MikolajPawel/PneumaticServoDrive_Arduino_byPM/README.md

## *If you wish to download all files from this repository you need to click "Code" and then "Download ZIP"*
# Didcatic workstation for pneumatic servo-drive with Arduino UNO and fast-switching valves.
https://youtu.be/sTllF3iPF24

https://youtu.be/fmIs1yKPOr8

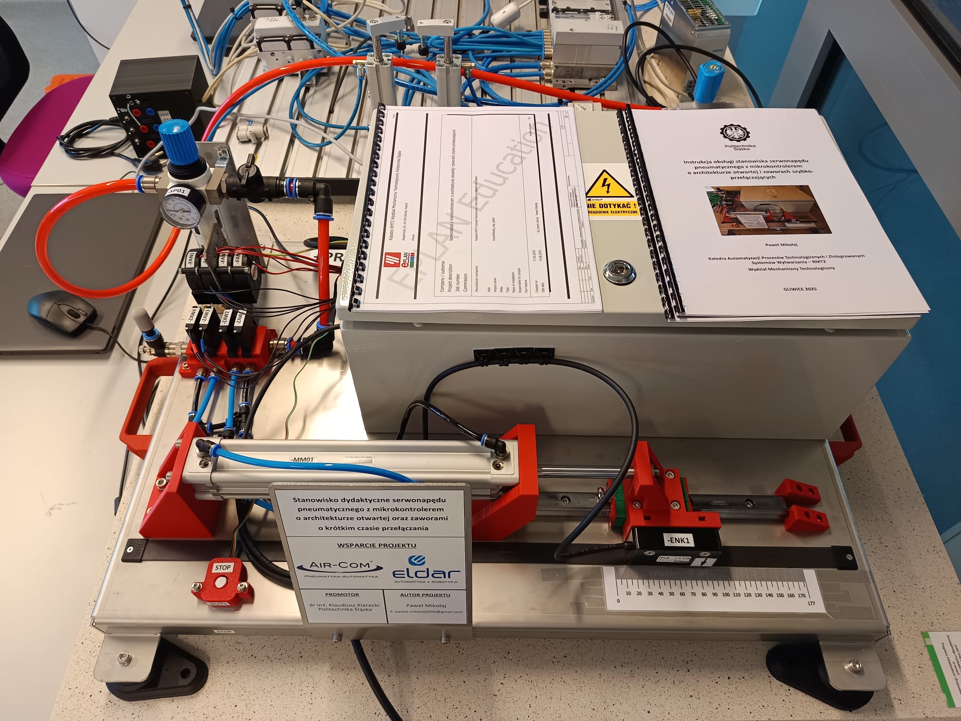
[picture p1: Zdjecie_stanowiska.jpg]
