MikolajPawel/PneumaticServoDrive_Arduino_byPM/Kod_Arduino/Biblioteki/PIDv1.h_link.txt

https://github.com/br3ttb/Arduino-PID-Library
