MikolajPawel/PneumaticServoDrive_Arduino_byPM/Konstrukcja/STL/PrzyciskSTOP_1.stl

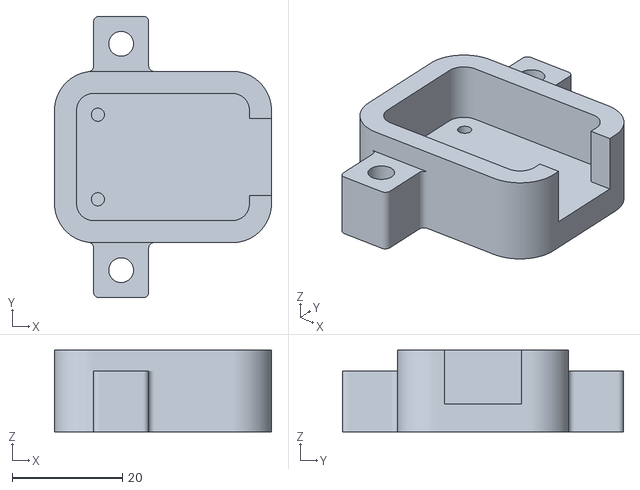
[picture p116: CAD file, 2025-08-22]
Konstrukcja/STL/PrzyciskSTOP_1.stl
39.4 x 51.1 x 14.8
