MikolajPawel/PneumaticServoDrive_Arduino_byPM/Konstrukcja/STL/uchwyt_konwerter_V1.stl

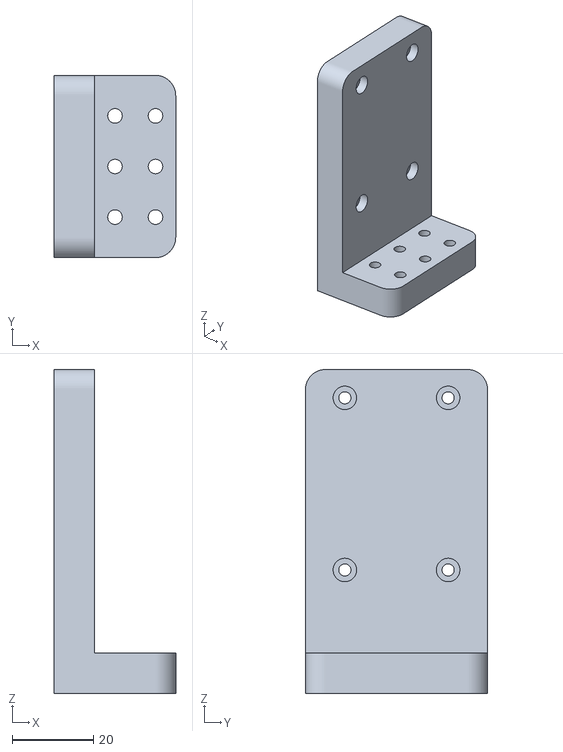
[picture p117: CAD file, 2025-08-22]
Konstrukcja/STL/uchwyt_konwerter_V1.stl
30.0 x 45.0 x 80.0
