MikolajPawel/PneumaticServoDrive_Arduino_byPM/Konstrukcja/STL/uchwyt_silownika2_V1.stl

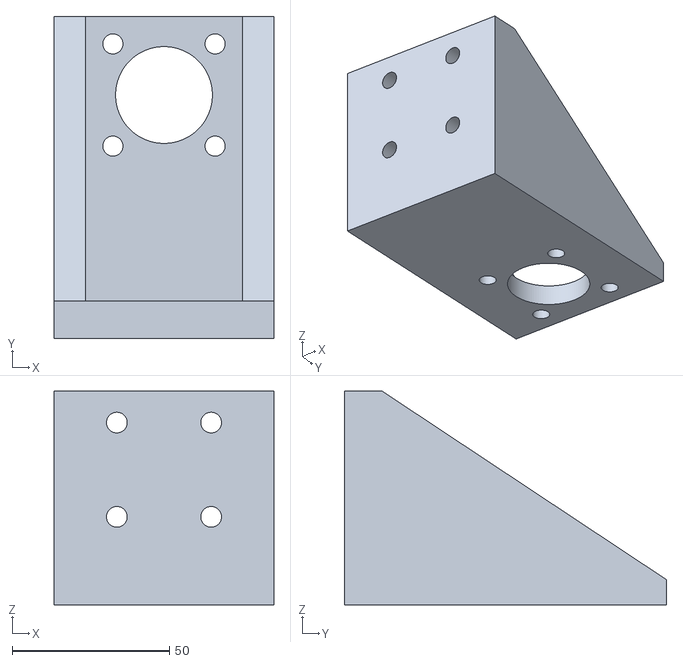
[picture p118: CAD file, 2025-08-22]
Konstrukcja/STL/uchwyt_silownika2_V1.stl
70.0 x 102.5 x 68.0
