MikolajPawel/PneumaticServoDrive_Arduino_byPM/Konstrukcja/STL/PrzyciskSTOP_2.stl

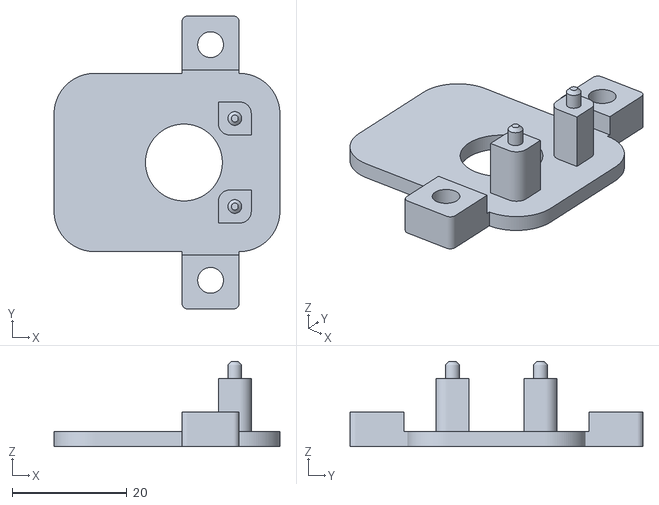
[picture p119: CAD file, 2025-08-22]
Konstrukcja/STL/PrzyciskSTOP_2.stl
39.4 x 51.1 x 14.9
