MikolajPawel/PneumaticServoDrive_Arduino_byPM/Konstrukcja/STL/uchwyt_silownika1_V1.stl

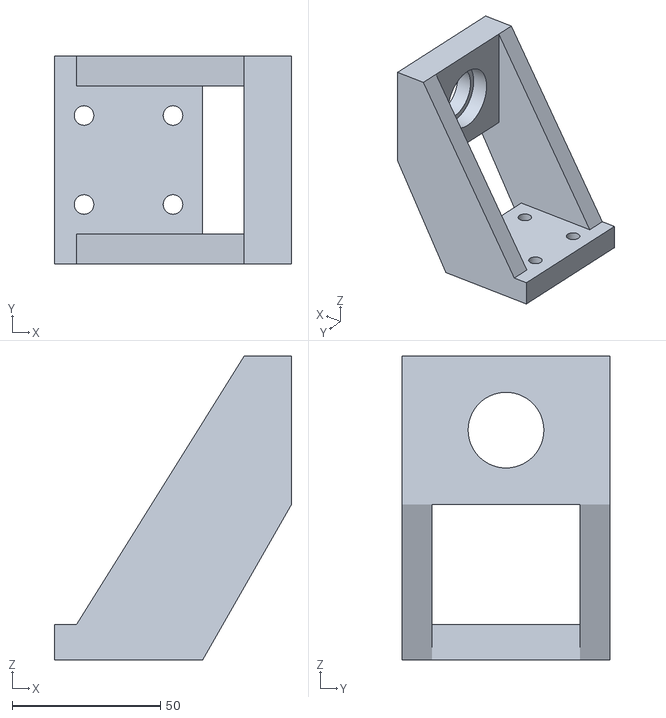
[picture p120: CAD file, 2025-08-22]
Konstrukcja/STL/uchwyt_silownika1_V1.stl
80.0 x 70.0 x 102.5
