MikolajPawel/PneumaticServoDrive_Arduino_byPM/Konstrukcja/STL/arduino_tuleja2_V2.stl

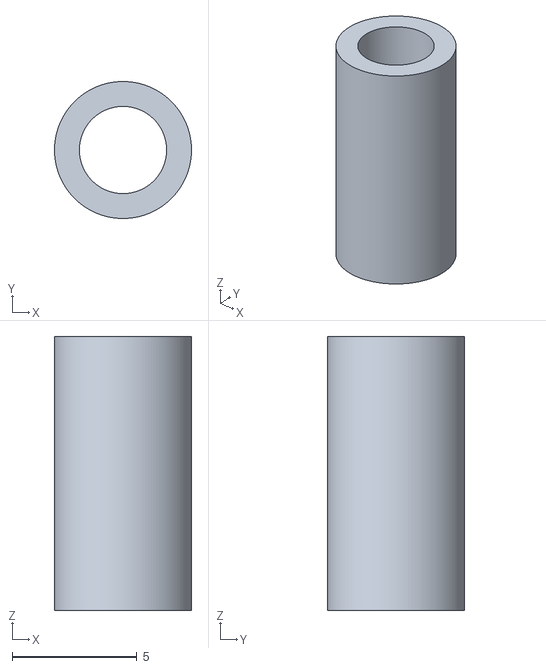
[picture p121: CAD file, 2025-08-22]
Konstrukcja/STL/arduino_tuleja2_V2.stl
5.50 x 5.50 x 11.0
