MikolajPawel/PneumaticServoDrive_Arduino_byPM/Konstrukcja/STL/blokada_hiwin_V1.stl

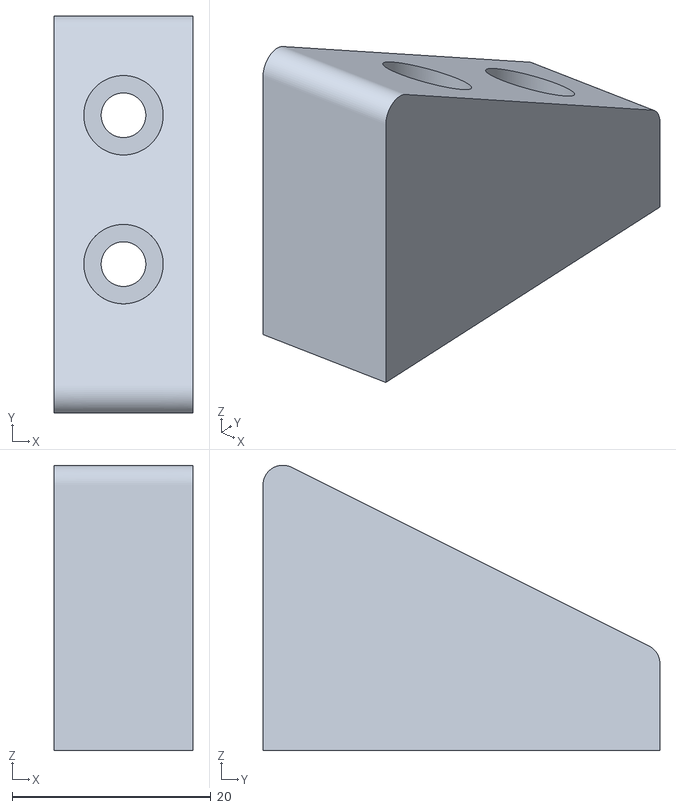
[picture p122: CAD file, 2025-08-22]
Konstrukcja/STL/blokada_hiwin_V1.stl
14.0 x 40.0 x 28.8
