MikolajPawel/PneumaticServoDrive_Arduino_byPM/Konstrukcja/STL/wozek_enkodera_V1.stl

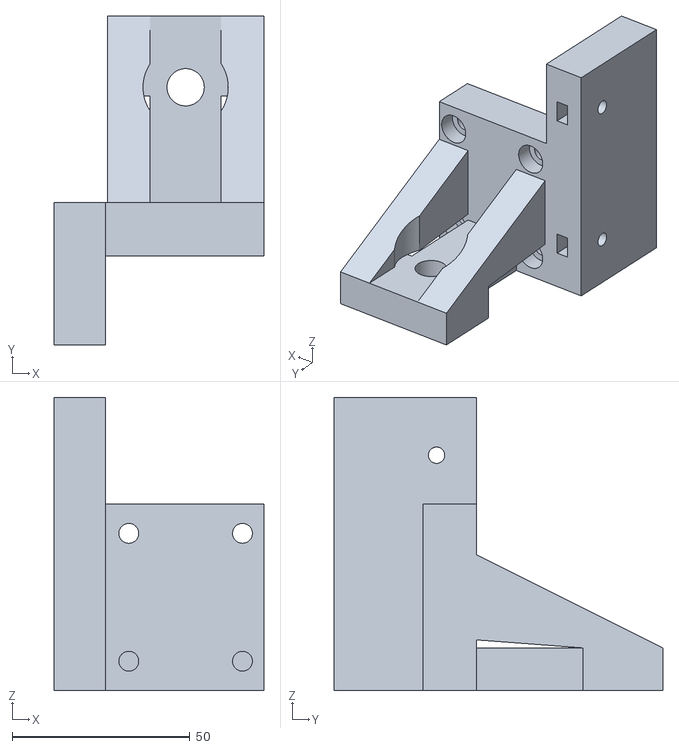
[picture p123: CAD file, 2025-08-22]
Konstrukcja/STL/wozek_enkodera_V1.stl
59.0 x 92.5 x 82.5
