MikolajPawel/PneumaticServoDrive_Arduino_byPM/Konstrukcja/STL/uchwyt_arduino_V1.stl

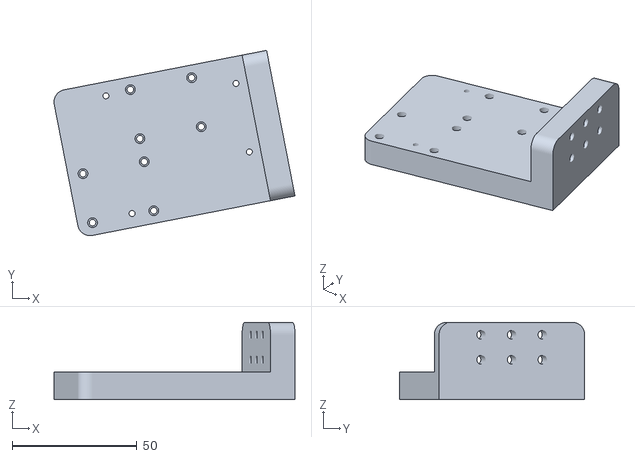
[picture p124: CAD file, 2025-08-22]
Konstrukcja/STL/uchwyt_arduino_V1.stl
96.5 x 74.2 x 31.0
