MikolajPawel/PneumaticServoDrive_Arduino_byPM/(list of files, cad)

Other CAD files:
Konstrukcja/inventor/Templates/English/ANSI (in).dwg
Konstrukcja/inventor/Templates/Metric/JIS.dwg
Konstrukcja/inventor/Templates/Standard.dwg
Konstrukcja/inventor/Templates/Metric/DIN.dwg
Konstrukcja/inventor/Templates/Metric/GOST.dwg
Konstrukcja/inventor/Templates/Metric/GB.dwg
Konstrukcja/inventor/Templates/Metric/MULTIPIT - 20220318 Template z tabelką.dwg
Konstrukcja/inventor/Templates/Metric/BSI.dwg
Konstrukcja/inventor/Templates/Metric/ANSI (mm).dwg
Konstrukcja/inventor/Templates/Metric/ISO.dwg
Konstrukcja/inventor/Design Data/AIT/Mold Design/mold design stop pin.ipt
Konstrukcja/inventor/Design Data/Cable & Harness/en-US/harness.iam
Konstrukcja/inventor/Design Data/Tube & Pipe/en-US/piping runs.iam
Konstrukcja/inventor/Templates/English/ANSI (in).idw
Konstrukcja/inventor/Templates/English/Mold Design (in).iam
Konstrukcja/inventor/Templates/English/Sheet Metal (in).ipt
Konstrukcja/inventor/Templates/English/Standard (in).iam
Konstrukcja/inventor/Templates/English/Standard (in).ipn
Konstrukcja/inventor/Templates/English/Standard (in).ipt
Konstrukcja/inventor/Templates/English/Weldment (ANSI).iam
Konstrukcja/inventor/Templates/Factory/Factory Layout (in).iam
Konstrukcja/inventor/Templates/Factory/Factory Layout (mm).iam
Konstrukcja/inventor/Templates/Metric/ANSI (mm).idw
Konstrukcja/inventor/Templates/Metric/BSI.idw
Konstrukcja/inventor/Templates/Metric/Balustrady - test/Fence generator - assembly level one.iam
Konstrukcja/inventor/Templates/Metric/Balustrady - test/Fence generator - assembly level one/Frame/Frame 1723491092086.iam
Konstrukcja/inventor/Templates/Metric/Balustrady - test/Fence generator - assembly level one/Frame/ISO 10799-2 42.4x2.0 1723491095419.ipt
Konstrukcja/inventor/Templates/Metric/Balustrady - test/Fence generator - assembly level one/Frame/ISO 10799-2 42.4x2.0 1723491095488.ipt
Konstrukcja/inventor/Templates/Metric/Balustrady - test/Fence generator - assembly level one/Frame/ISO 10799-2 42.4x2.0 1723491095562.ipt
Konstrukcja/inventor/Templates/Metric/Balustrady - test/Fence generator - assembly level one/Frame/ISO 10799-2 42.4x2.0 1723491095630.ipt
Konstrukcja/inventor/Templates/Metric/Balustrady - test/Fence generator - assembly level one/Frame/ISO 10799-2 42.4x2.0 1723491095702.ipt
Konstrukcja/inventor/Templates/Metric/Balustrady - test/Fence generator - assembly level one/Frame/ISO 10799-2 42.4x2.0 1723491095775.ipt
Konstrukcja/inventor/Templates/Metric/Balustrady - test/Fence generator - assembly level one/Frame/ISO 10799-2 42.4x2.0 1723491095846.ipt
Konstrukcja/inventor/Templates/Metric/Balustrady - test/Fence generator - assembly level one/Frame/Skeleton 1723491092087.ipt
Konstrukcja/inventor/Templates/Metric/Balustrady - test/Fence generator - sketch-01.ipt
Konstrukcja/inventor/Templates/Metric/Balustrady - test/Fence generator - sketch.ipt
Konstrukcja/inventor/Templates/Metric/DIN.idw
Konstrukcja/inventor/Templates/Metric/GB.idw
Konstrukcja/inventor/Templates/Metric/GOST.idw
Konstrukcja/inventor/Templates/Metric/ISO.idw
Konstrukcja/inventor/Templates/Metric/JIS.idw
Konstrukcja/inventor/Templates/Metric/MULTIPIT - 20220318 Template z tabelką.idw
Konstrukcja/inventor/Templates/Metric/Mold Design (DIN).iam
Konstrukcja/inventor/Templates/Metric/Mold Design (mm).iam
Konstrukcja/inventor/Templates/Metric/Sheet Metal (DIN).ipt
Konstrukcja/inventor/Templates/Metric/Sheet Metal (mm).ipt
Konstrukcja/inventor/Templates/Metric/Standard (DIN).iam
Konstrukcja/inventor/Templates/Metric/Standard (DIN).ipn
Konstrukcja/inventor/Templates/Metric/Standard (DIN).ipt
Konstrukcja/inventor/Templates/Metric/Standard (mm).iam
Konstrukcja/inventor/Templates/Metric/Standard (mm).ipn
Konstrukcja/inventor/Templates/Metric/Standard (mm).ipt
Konstrukcja/inventor/Templates/Metric/Weldment (ANSI - mm).iam
Konstrukcja/inventor/Templates/Metric/Weldment (BSI).iam
Konstrukcja/inventor/Templates/Metric/Weldment (DIN).iam
Konstrukcja/inventor/Templates/Metric/Weldment (GB).iam
Konstrukcja/inventor/Templates/Metric/Weldment (ISO).iam
Konstrukcja/inventor/Templates/Metric/Weldment (JIS).iam
Konstrukcja/inventor/Templates/Mold Design/Mold Design.iam
Konstrukcja/inventor/Templates/PM_2024v03.idw
Konstrukcja/inventor/Templates/PM_26062025.idw
Konstrukcja/inventor/Templates/Sheet Metal.ipt
Konstrukcja/inventor/Templates/Standard.iam
Konstrukcja/inventor/Templates/Standard.idw
Konstrukcja/inventor/Templates/Standard.ipn
Konstrukcja/inventor/Templates/Standard.ipt
Konstrukcja/inventor/Templates/StandardFactoryLayout.iam
Konstrukcja/inventor/Templates/Weldment.iam
Konstrukcja/inventor/Workspace/Arduino_zlozenie.iam
Konstrukcja/inventor/Workspace/DF Robot DFR0029-R.ipt
Konstrukcja/inventor/Workspace/DFR-08104.ipt
Konstrukcja/inventor/Workspace/MontazWszafie/1201578_PHOENIX/1201578_PHOENIX/1201578_PHOENIX.ipt
Konstrukcja/inventor/Workspace/MontazWszafie/2698103/2698103/NS_35_7.5_PERF_18X5.2_2000MM-Select.ipt
Konstrukcja/inventor/Workspace/MontazWszafie/Arduino-cz1.ipt
Konstrukcja/inventor/Workspace/MontazWszafie/Arduino-cz2.ipt
Konstrukcja/inventor/Workspace/MontazWszafie/Uchwyt_arduino.ipt
Konstrukcja/inventor/Workspace/MontazWszafie/Uchwyt_konwerter.iam
Konstrukcja/inventor/Workspace/MontazWszafie/Uchwyt_konwerter.ipt
Konstrukcja/inventor/Workspace/Part1.ipt
Konstrukcja/inventor/Workspace/Part15.ipt
Konstrukcja/inventor/Workspace/Part6.ipt
Konstrukcja/inventor/Workspace/Plyta_SMC.ipt
Konstrukcja/inventor/Workspace/PrzyciskSTOP.iam
Konstrukcja/inventor/Workspace/PrzyciskSTOP_1.ipt
Konstrukcja/inventor/Workspace/PrzyciskSTOP_2.ipt
Konstrukcja/inventor/Workspace/Stół.iam
Konstrukcja/inventor/Workspace/Stół.ipt
Konstrukcja/inventor/Workspace/Uchwyt_ZPP.ipt
Konstrukcja/inventor/Workspace/Zakupowe/FESTO/MS4-EM1FR-14-D6-E-P-M-AG-MPA-WPE-B/8092760 MS4-MV-B---(46_high_m).ipt
Konstrukcja/inventor/Workspace/Zakupowe/FESTO/MS4-EM1FR-14-D6-E-P-M-AG-MPA-WPE-B/8098261 MS4-LFR-1_4-D6-E-P-M-AG-MPA-B---(high).ipt
Konstrukcja/inventor/Workspace/Zakupowe/FESTO/MS4-EM1FR-14-D6-E-P-M-AG-MPA-WPE-B/8098374 MS4-EM1FR-1_4-D6-E-P-M-AG-MPA-WPE-B.iam
Konstrukcja/inventor/Workspace/Zakupowe/FESTO/MS4-EM1FR-14-D6-E-P-M-AG-MPA-WPE-B/8116179 MS4-MV-B---(0_high_m).ipt
Konstrukcja/inventor/Workspace/Zakupowe/LV_FO-60-14_SJF-M6_0/LV_FO-60-14_SJF-M6_0/Adjustable feet for ground mounting LV.FO-60-14+SJF-M6 (0)-1.ipt
Konstrukcja/inventor/Workspace/Zakupowe/LV_FO-60-14_SJF-M6_0/LV_FO-60-14_SJF-M6_0/LV_FO-60-14_SJF-M6_0.iam
Konstrukcja/inventor/Workspace/Zakupowe/LV_FO-60-14_SJF-M6_0/LV_FO-60-14_SJF-M6_0/Spherical joint SJF-14-M6.ipt
Konstrukcja/inventor/Workspace/Zakupowe/elesa/M_443_140-6-CH-C6/M_443_140-6-CH-C6/M_443_140-6-CH-C6.ipt
Konstrukcja/inventor/Workspace/Zakupowe/hiwin/HGH20CA1R250Z0H_FILE_1/HGH20CA1R250Z0H_FILE_1/2025_06_08_12_44_05_0783.ipt
Konstrukcja/inventor/Workspace/Zakupowe/hiwin/HGH20CA1R250Z0H_FILE_1/HGH20CA1R250Z0H_FILE_1/2025_06_08_12_44_05_0798.ipt
Konstrukcja/inventor/Workspace/Zakupowe/hiwin/HGH20CA1R250Z0H_FILE_1/HGH20CA1R250Z0H_FILE_1/HGH20CA1R250Z0H_FILE_1.iam
Konstrukcja/inventor/Workspace/Zakupowe/lika/LIKA LKM-1439.ipt
Konstrukcja/inventor/Workspace/Zakupowe/lika/LIKA SMAX-MB-PRG-L2/LIKA SMAX-MB-PRG-L2/LIKA SMAX-MB-PRG-L2.ipt
Konstrukcja/inventor/Workspace/Zakupowe/lika/MTAZ-500-50-1.ipt
Konstrukcja/inventor/Workspace/Zakupowe/schneider/NSYS3D5320P_3D-Simplified/NSYS3D5320P_3D-Simplified/51140548-S1_500X300_1LAST_VERSI.ipt
Konstrukcja/inventor/Workspace/Zakupowe/schneider/NSYS3D5320P_3D-Simplified/NSYS3D5320P_3D-Simplified/51140548-S_500X300_1LAST_VERSIO.ipt
Konstrukcja/inventor/Workspace/Zakupowe/schneider/NSYS3D5320P_3D-Simplified/NSYS3D5320P_3D-Simplified/51140548-S_5X3_ASM_1LAST_VERSIO_ASM.iam
Konstrukcja/inventor/Workspace/Zakupowe/schneider/NSYS3D5320P_3D-Simplified/NSYS3D5320P_3D-Simplified/51140582-S01_1LAST_VERSION_1__5.ipt
Konstrukcja/inventor/Workspace/Zakupowe/schneider/NSYS3D5320P_3D-Simplified/NSYS3D5320P_3D-Simplified/51140582-S02_ASM_1LAST_VERSIO_5_ASM.iam
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
