MikolajPawel/PneumaticServoDrive_Arduino_byPM/Dokumentacja_serwisowa/Dokumentacja_serwisowa.pdf

## Akademicka 2A, 44-100 Gliwice, Poland

## Phone

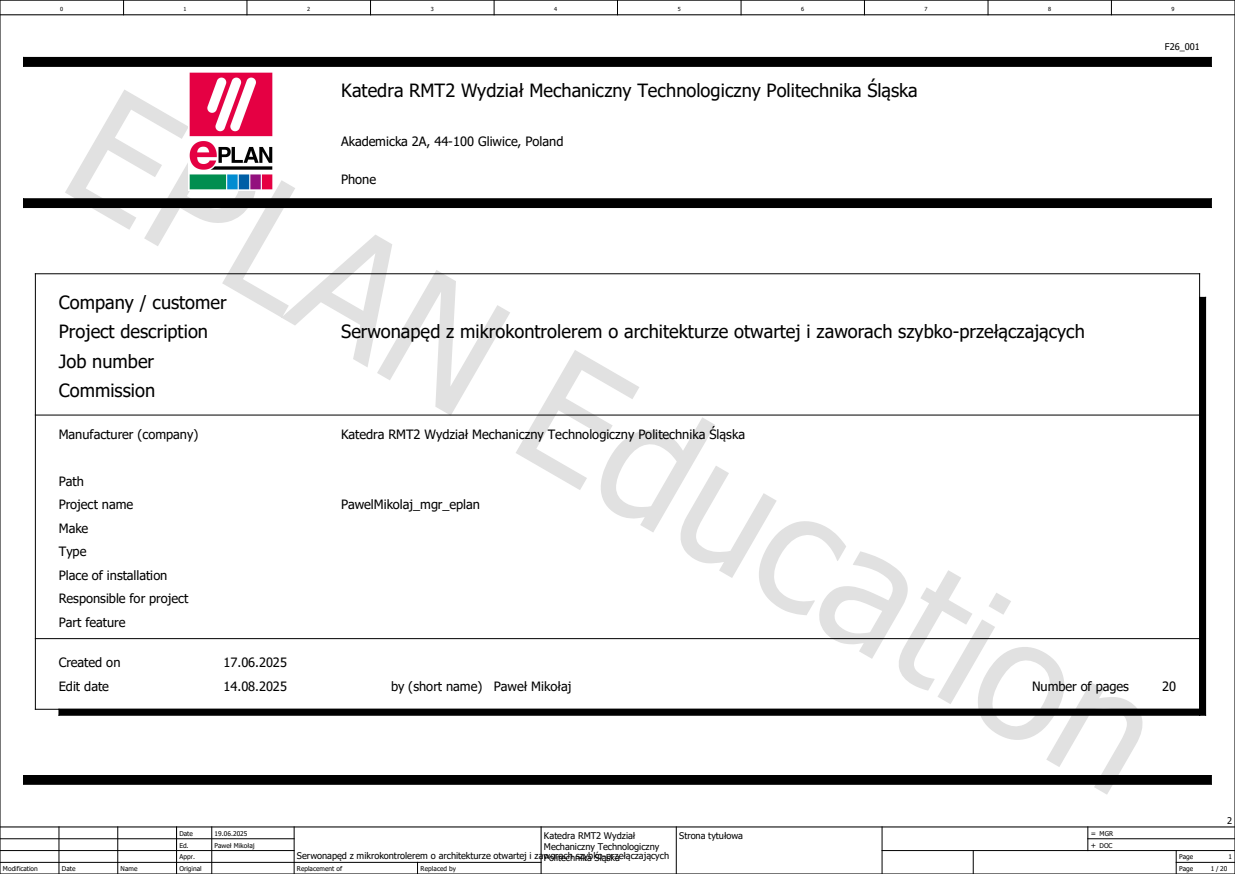
[picture p125: page 1]
Project description; Serwonapęd z mikrokontrolerem o architekturze otwartej i zaworach szybko-przełączających; Commission; Edit date; Created on; Job number; Paweł Mikołaj; Manufacturer (company); Project name; PawelMikolaj_mgr_eplan; Company / customer

Katedra RMT2 Wydział Mechaniczny Technologiczny Politechnika Śląska

Path
Make
Type
Place of installation
Responsible for project
Part feature

by (short name)

Number of pages

19.06.2025 Katedra RMT2 Wydział | Serwonapęd z mikrokontrolerem o architekturze otwartej i zaworach szybko-przełączających | Mechaniczny Technologiczny Politechnika Śląska | Strona tytułowa | = MGR

Ed. | Paweł Mikołaj | | | | + DOC
Appr. | | | | | | 1 Page

Modification | Date | Name | Original | | Replacement of | Replaced by | | | | 1 / 20

Page | Page type | Page description | Date | Edited by

# Table of contents

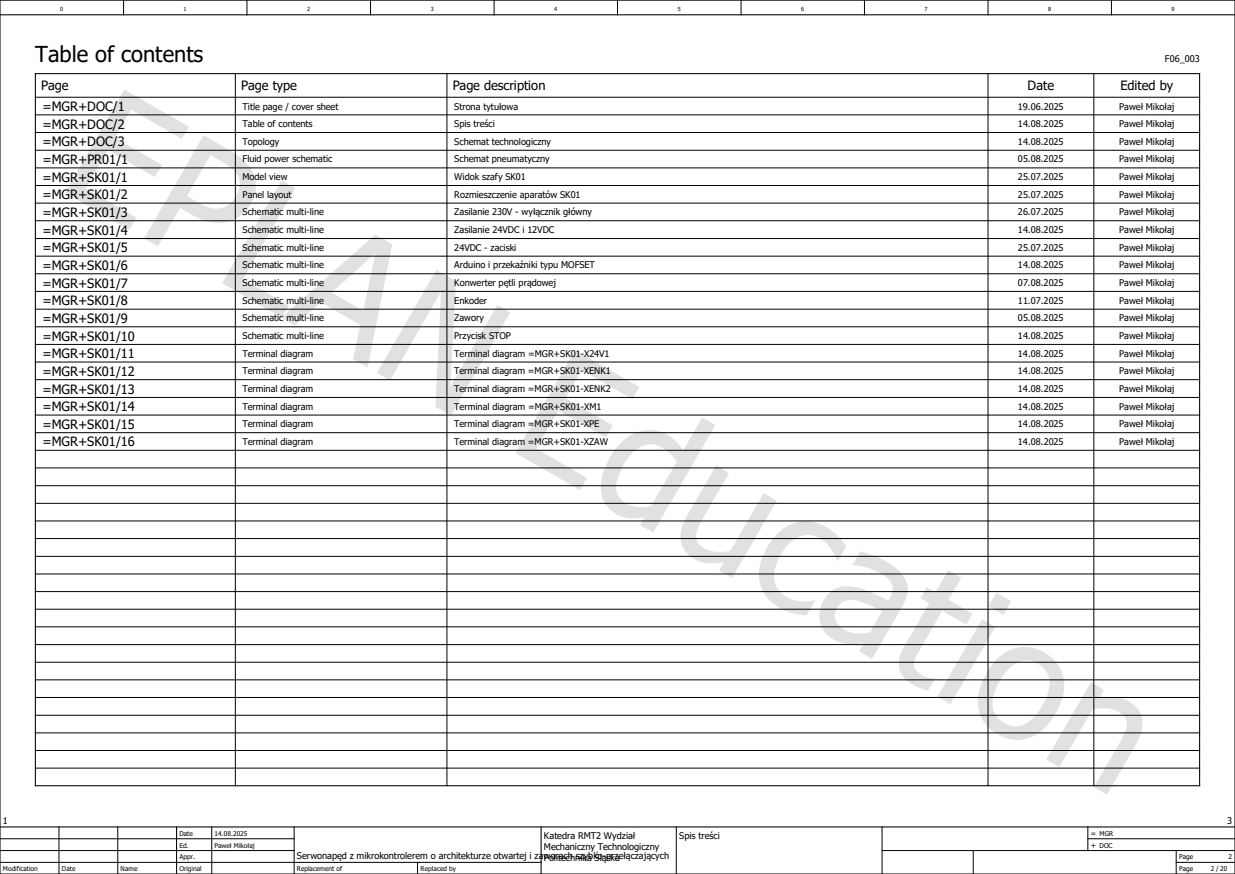
[picture p126: page 2]
DOC

=MGR+DOC/1 | Title page / cover sheet | | 19.06.2025 Strona tytułowa | Paweł Mikołaj
=MGR+DOC/2 | Table of contents | | 14.08.2025 Spis treści | Paweł Mikołaj
=MGR+DOC/3 | Topology | Schemat technologiczny | 14.08.2025 | Paweł Mikołaj
=MGR+PR01/1 | Fluid power schematic | Schemat pneumatyczny | 05.08.2025 | Paweł Mikołaj
=MGR+SK01/1 | Model view | Widok szafy SK01 | 25.07.2025 | Paweł Mikołaj
=MGR+SK01/2 | Panel layout | Rozmieszczenie aparatów SK01 | 25.07.2025 | Paweł Mikołaj
=MGR+SK01/3 | Schematic multi-line | Zasilanie 230V - wyłącznik główny | 26.07.2025 | Paweł Mikołaj
=MGR+SK01/4 | Schematic multi-line | Zasilanie 24VDC i 12VDC | 14.08.2025 | Paweł Mikołaj
=MGR+SK01/5 | Schematic multi-line | 24VDC - zaciski | 25.07.2025 | Paweł Mikołaj
=MGR+SK01/6 | Schematic multi-line | Arduino i przekaźniki typu MOFSET | 14.08.2025 | Paweł Mikołaj
=MGR+SK01/7 | Schematic multi-line | Konwerter pętli prądowej | 07.08.2025 | Paweł Mikołaj
=MGR+SK01/8 | Schematic multi-line | Enkoder | 11.07.2025 | Paweł Mikołaj
=MGR+SK01/9 | Schematic multi-line | Zawory | 05.08.2025 | Paweł Mikołaj
=MGR+SK01/10 | Schematic multi-line | Przycisk STOP | 14.08.2025 | Paweł Mikołaj
=MGR+SK01/11 | Terminal diagram | | 14.08.2025 Terminal diagram =MGR+SK01-X24V1 | Paweł Mikołaj
=MGR+SK01/12 | Terminal diagram | | 14.08.2025 Terminal diagram =MGR+SK01-XENK1 | Paweł Mikołaj
=MGR+SK01/13 | Terminal diagram | | 14.08.2025 Terminal diagram =MGR+SK01-XENK2 | Paweł Mikołaj
=MGR+SK01/14 | Terminal diagram | | 14.08.2025 Terminal diagram =MGR+SK01-XM1 | Paweł Mikołaj
=MGR+SK01/15 | Terminal diagram | | 14.08.2025 Terminal diagram =MGR+SK01-XPE | Paweł Mikołaj
=MGR+SK01/16 | Terminal diagram | | 14.08.2025 Terminal diagram =MGR+SK01-XZAW | Paweł Mikołaj

14.08.2025 Katedra RMT2 Wydział | Politechnika Śląska | Spis treści

# Stanowisko dydaktyczne =MGR

+PR01 | +SK01

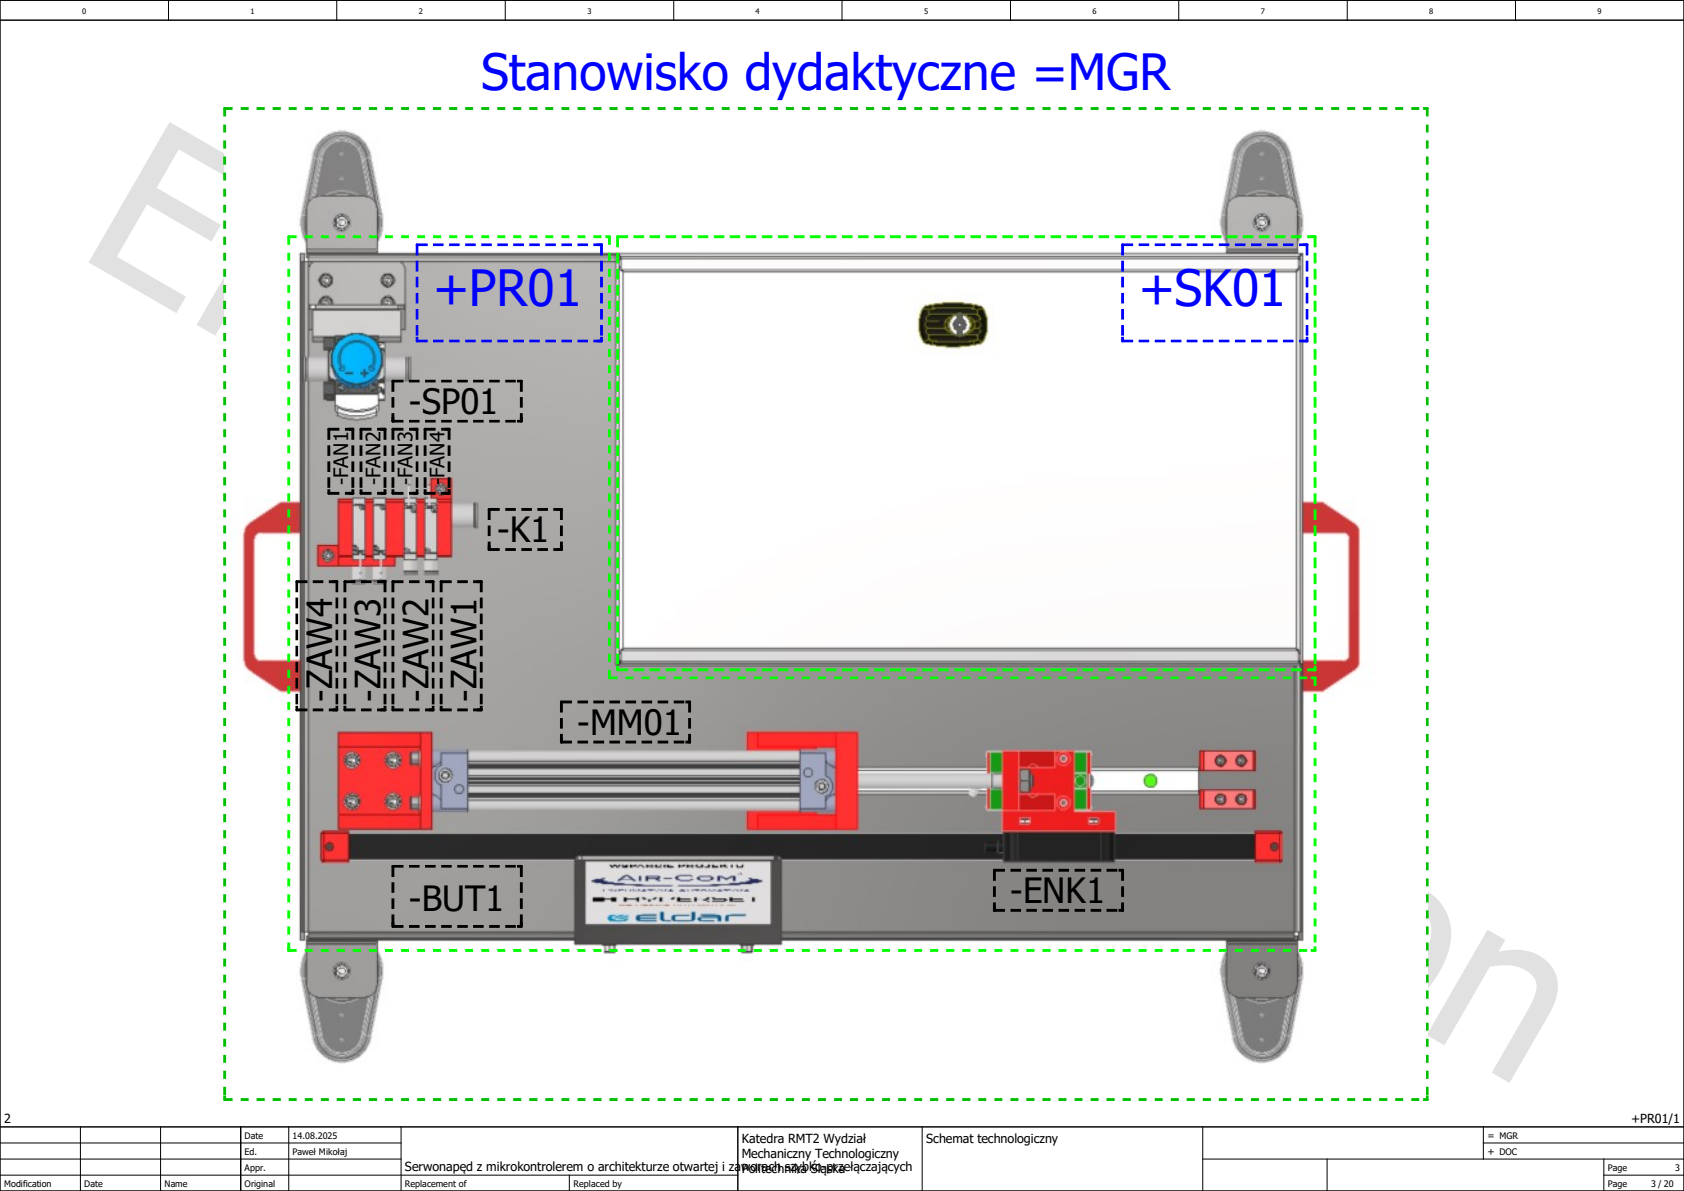
[picture p127: page 3]
DOC; Schemat technologiczny; Politechnika Śląska; -BUT1

-K1 ⁻FAN¹ -FAN² -FAN³ -FAN⁴

-ENK1 ⁻ZAW⁴ -ZAW³ -ZAW² -ZAW¹

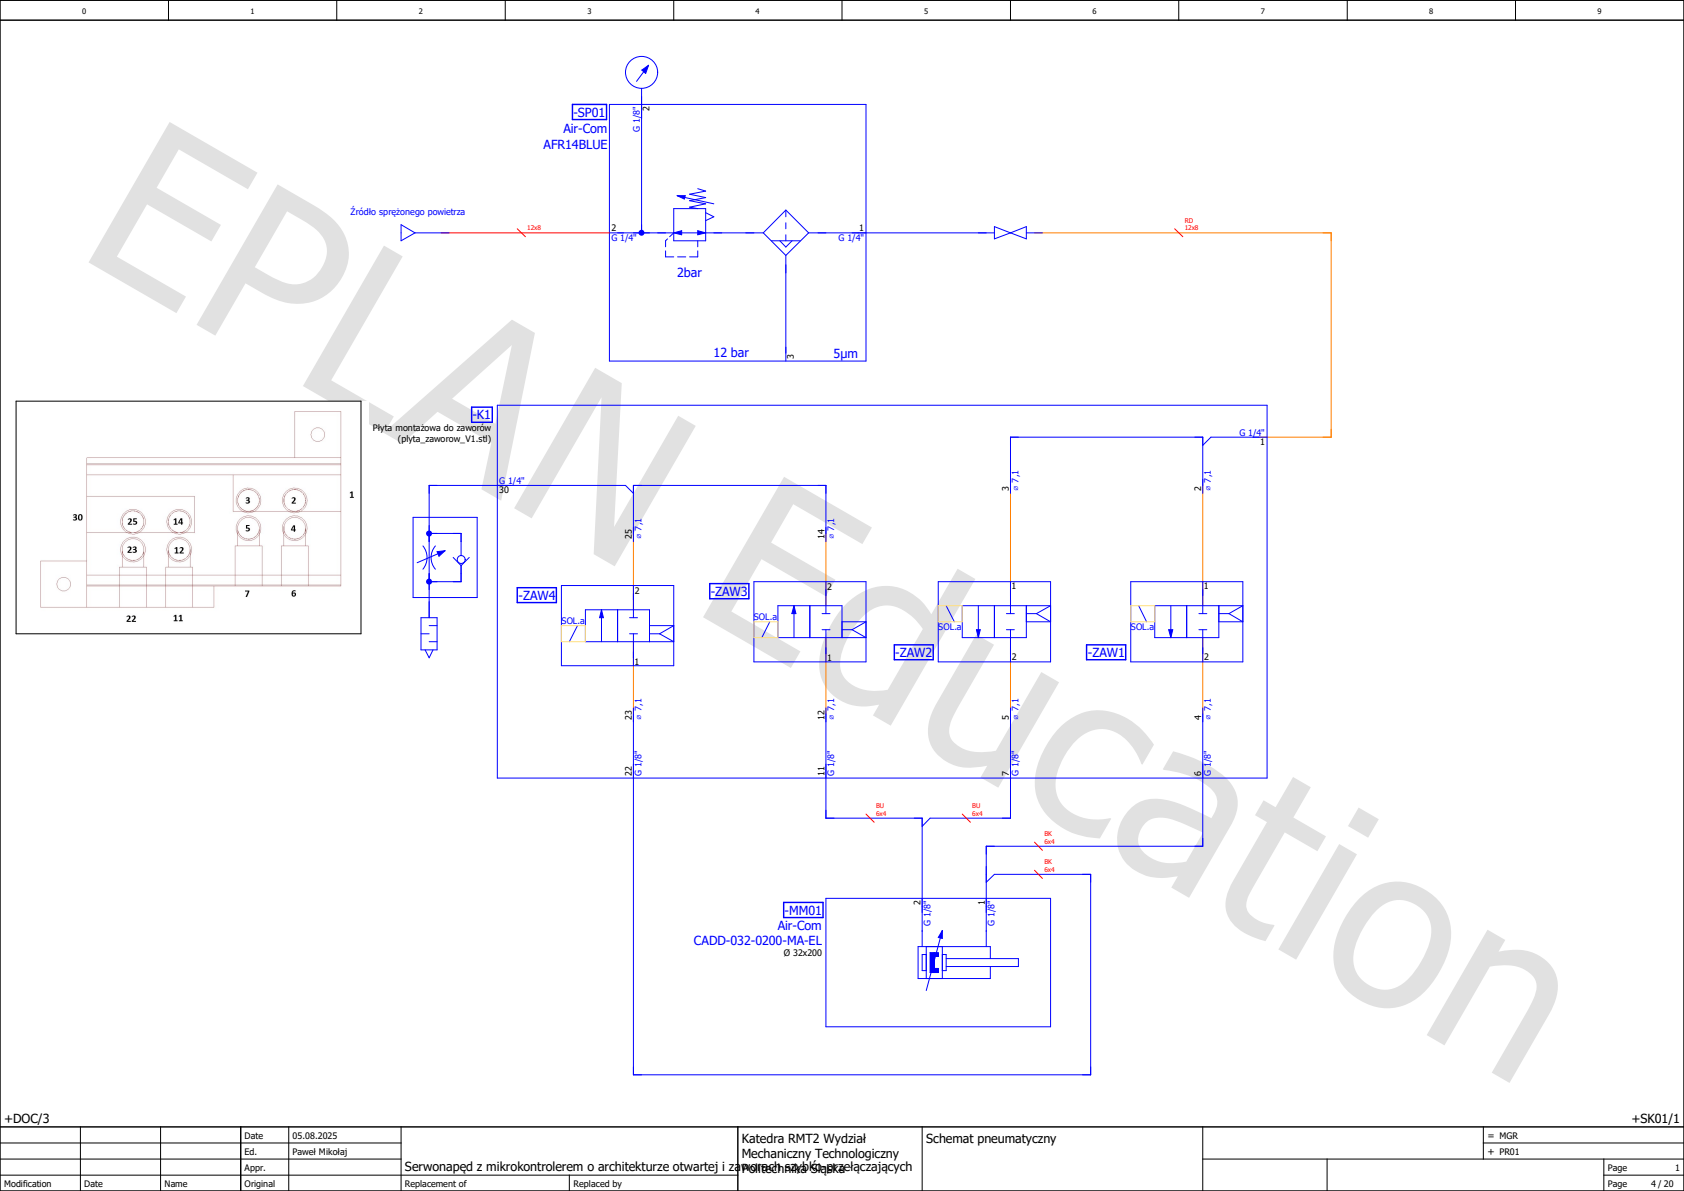
[picture p128: page 4]
+DOC/3; 2bar; 2 G 1/8" -SP01 Air-Com AFR14BLUE; 12 bar; -MM01 Air-Com; SOL.a; -ZAW1; -ZAW2; -ZAW3; -ZAW4; (plyta_zaworow_V1.stl)

Źródło sprężonego powietrza

Płyta montażowa do zaworów

CADD-032-0200-MA-EL

05.08.2025 Katedra RMT2 Wydział | Politechnika Śląska | Schemat pneumatyczny

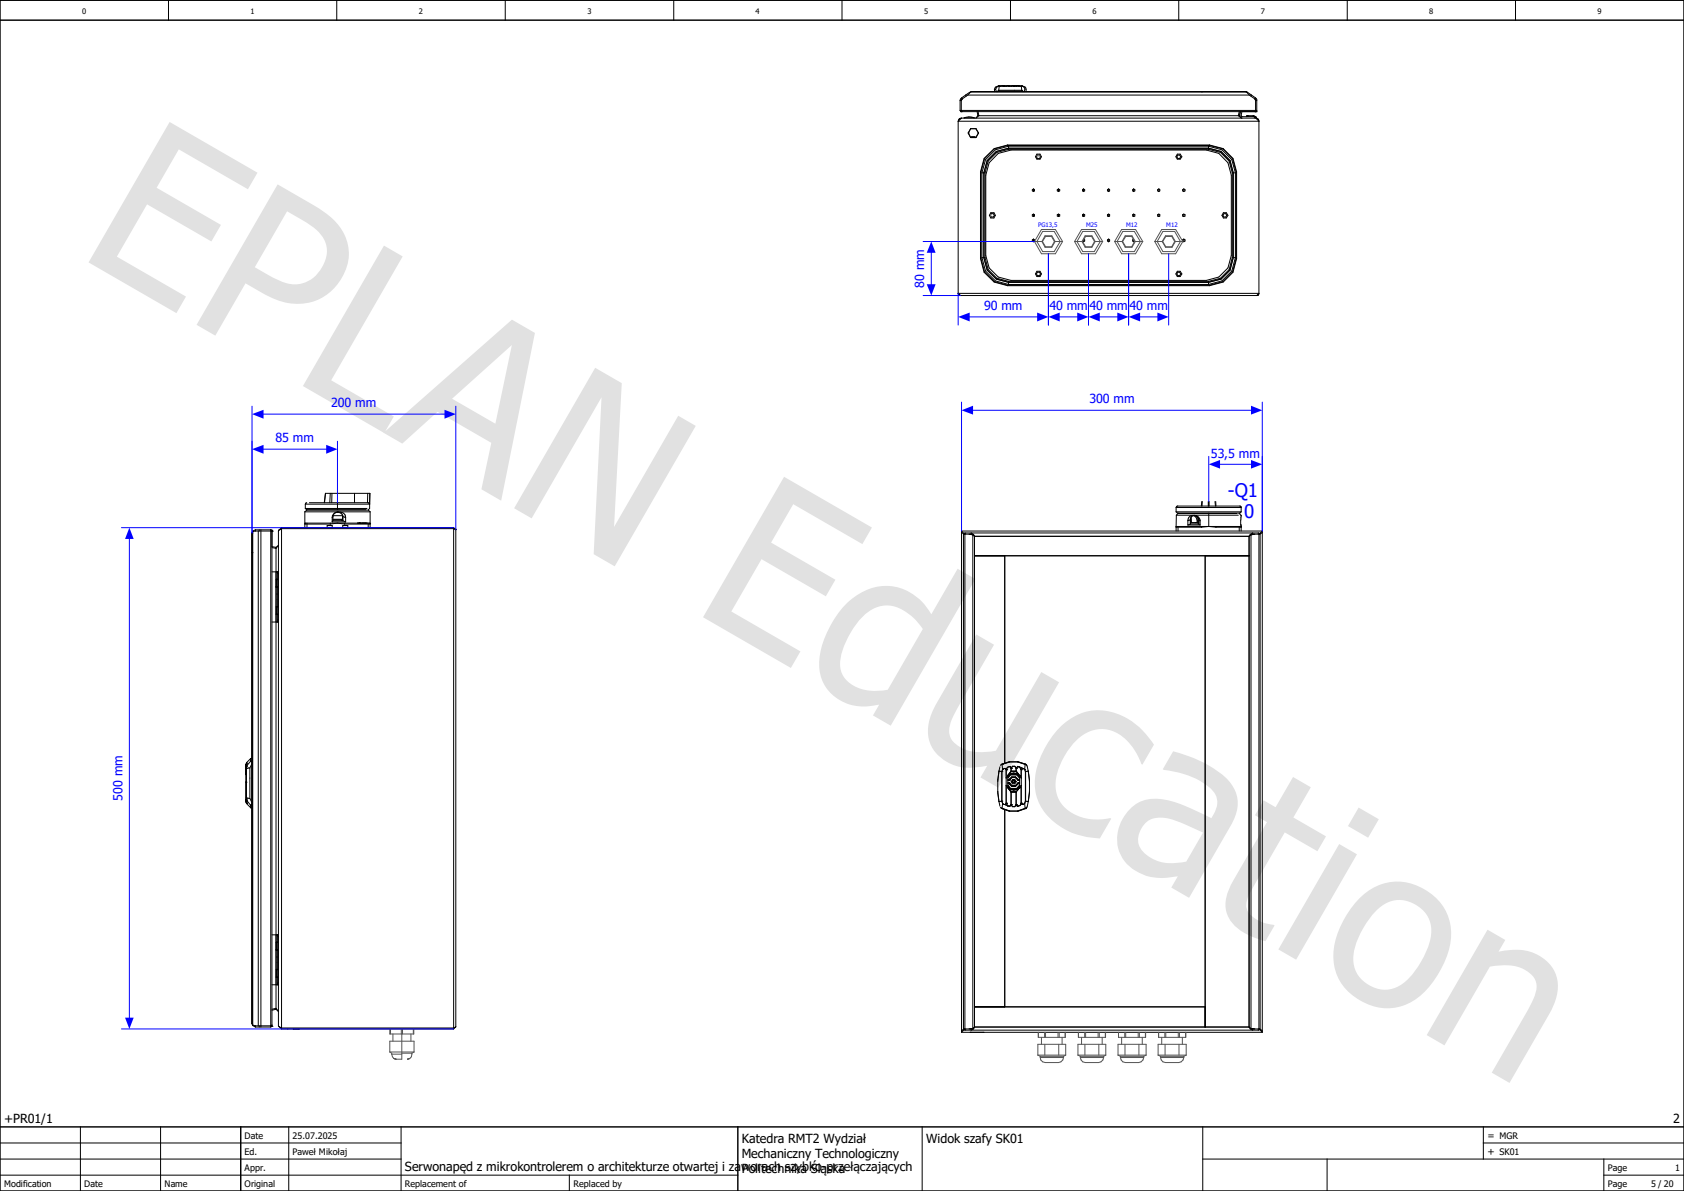
[picture p129: page 5]

25.07.2025 Katedra RMT2 Wydział | Politechnika Śląska | Widok szafy SK01

Legenda szafy sterowniczej | legenda_szafy
0 | U1 25x40 | 25x40

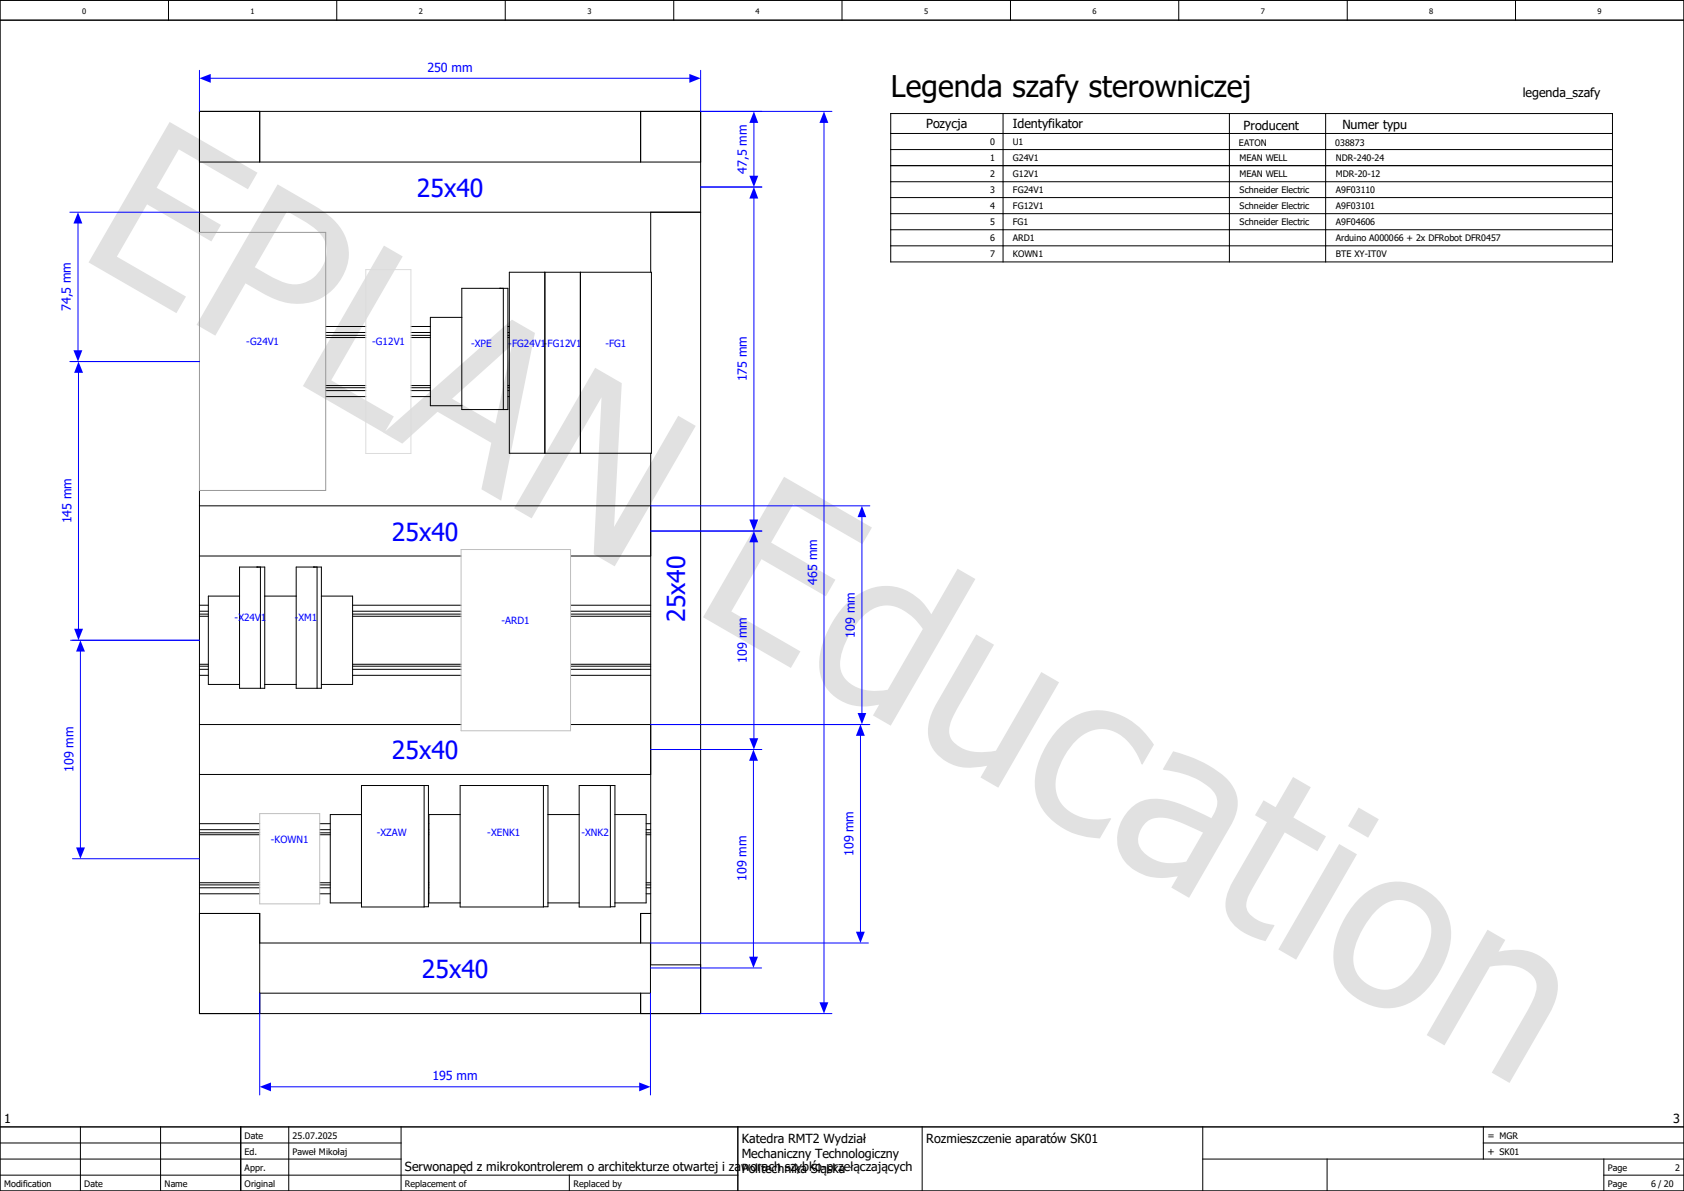
[picture p130: page 6]
ARD1; Arduino A000066 + 2x DFRobot DFR0457; KOWN1; BTE XY-IT0V; -ARD1; -KOWN1; -XPE; -XZAW; -XENK1; -XNK2

Pozycja | Identyfikator | Producent | Numer typu

1 | G24V1 | MEAN WELL | NDR-240-24
2 | G12V1 | MEAN WELL | MDR-20-12
3 | FG24V1 | Schneider Electric | A9F03110
4 | FG12V1 | Schneider Electric | A9F03101
5 | FG1 | Schneider Electric | A9F04606

EATON | 038873

25.07.2025 Katedra RMT2 Wydział | Politechnika Śląska | Rozmieszczenie aparatów SK01

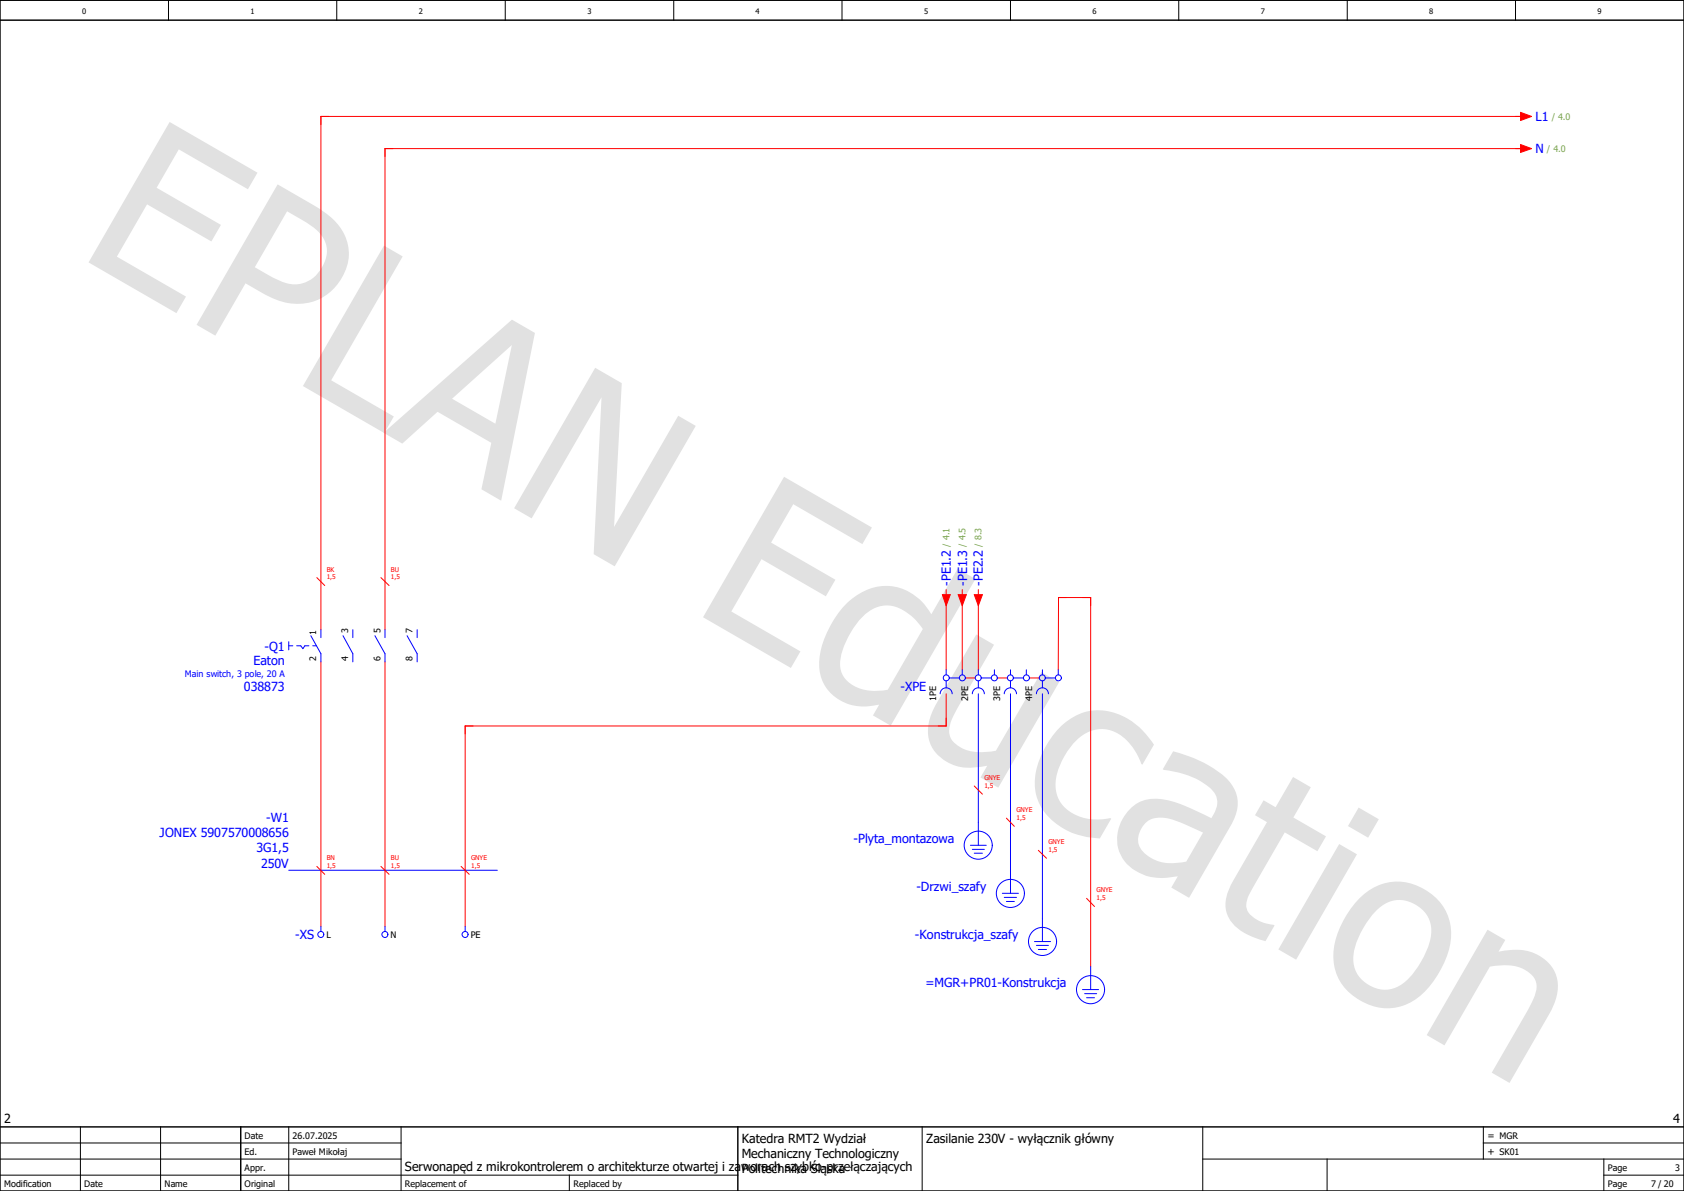
[picture p131: page 7]
-Q1 Eaton; JONEX 5907570008656; GNYE; -XPE 1PE; -Plyta_montazowa; -Drzwi_szafy; -Konstrukcja_szafy; =MGR+PR01-Konstrukcja

Main switch, 3 pole, 20 A

26.07.2025 Katedra RMT2 Wydział | Politechnika Śląska | Zasilanie 230V - wyłącznik główny

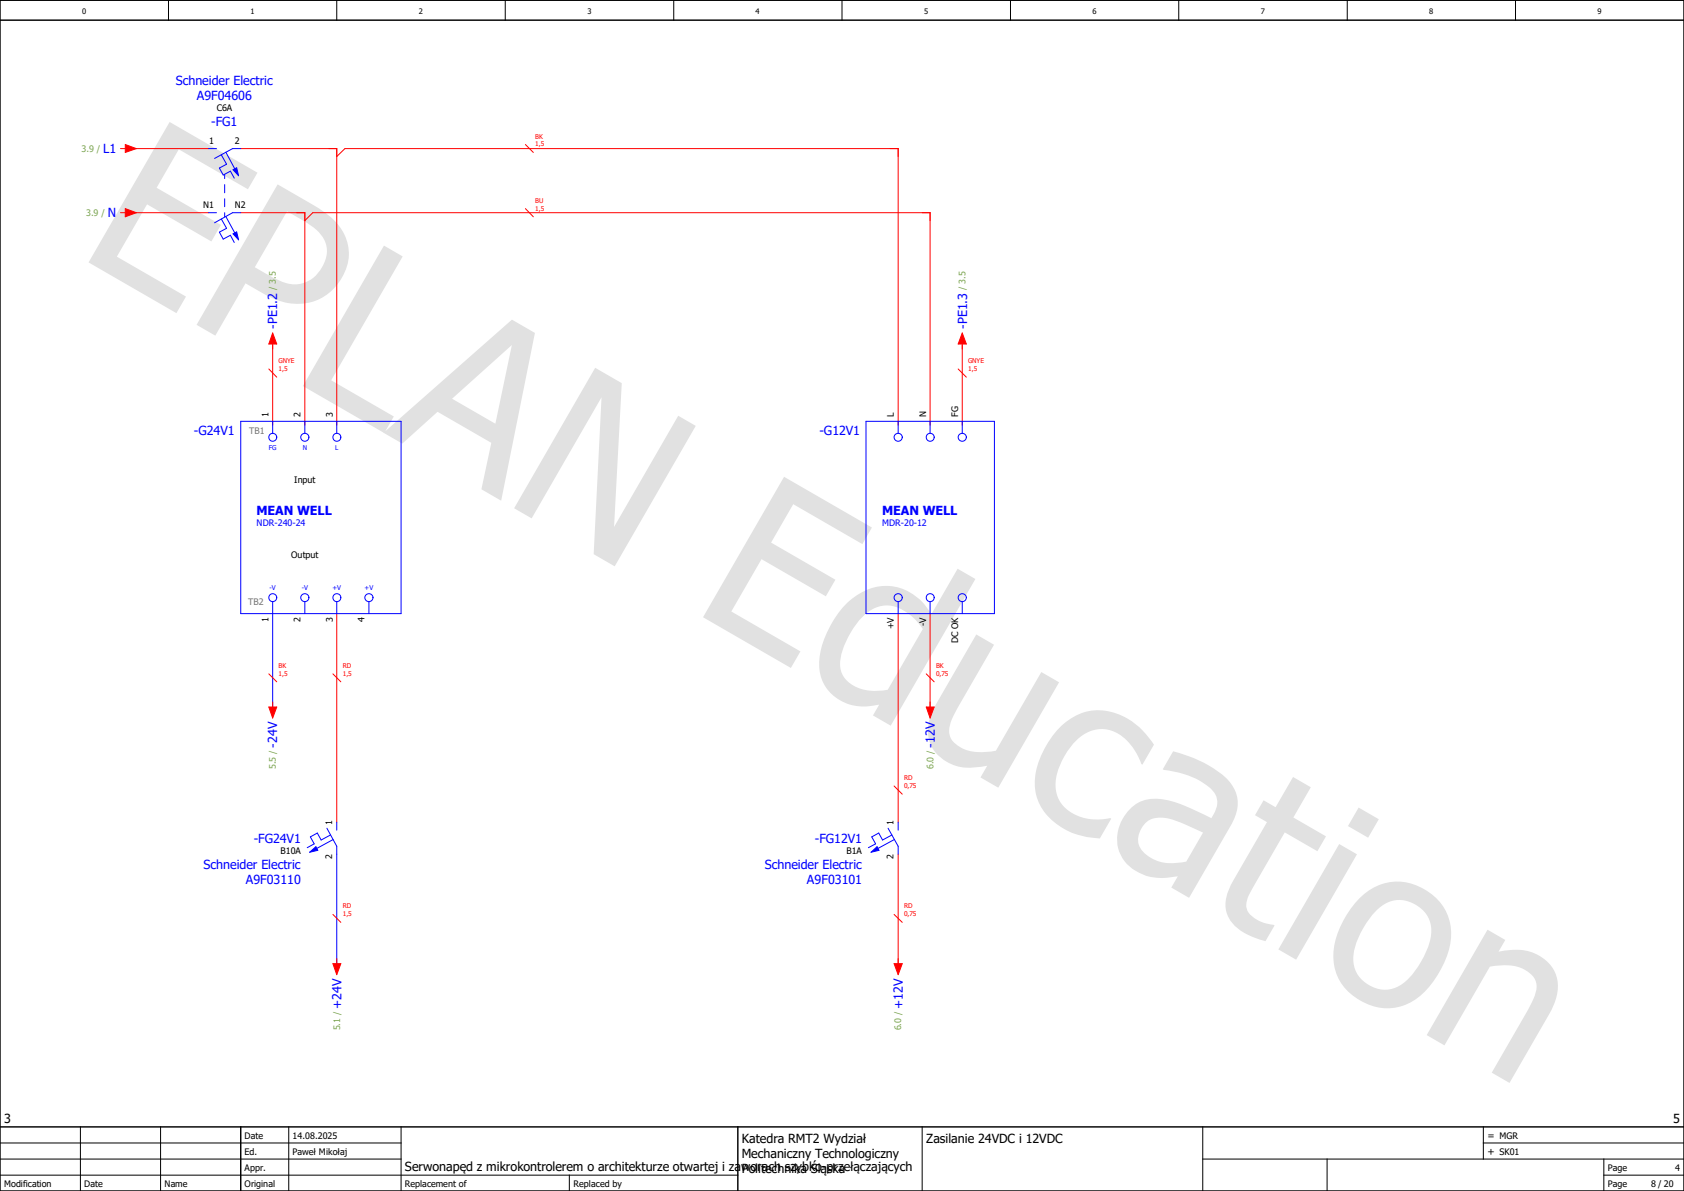
[picture p132: page 8]
Zasilanie 24VDC i 12VDC; Politechnika Śląska; Input; Output; MEAN WELL NDR-240-24; MEAN WELL; MDR-20-12 +V; Schneider Electric; -FG24V1 B10A Schneider Electric; -FG12V1 B1A Schneider Electric; GNYE; -PE1.3 / 3.5 +²⁴V / 5.1 -24V / 5.5; +¹²V / 6.0

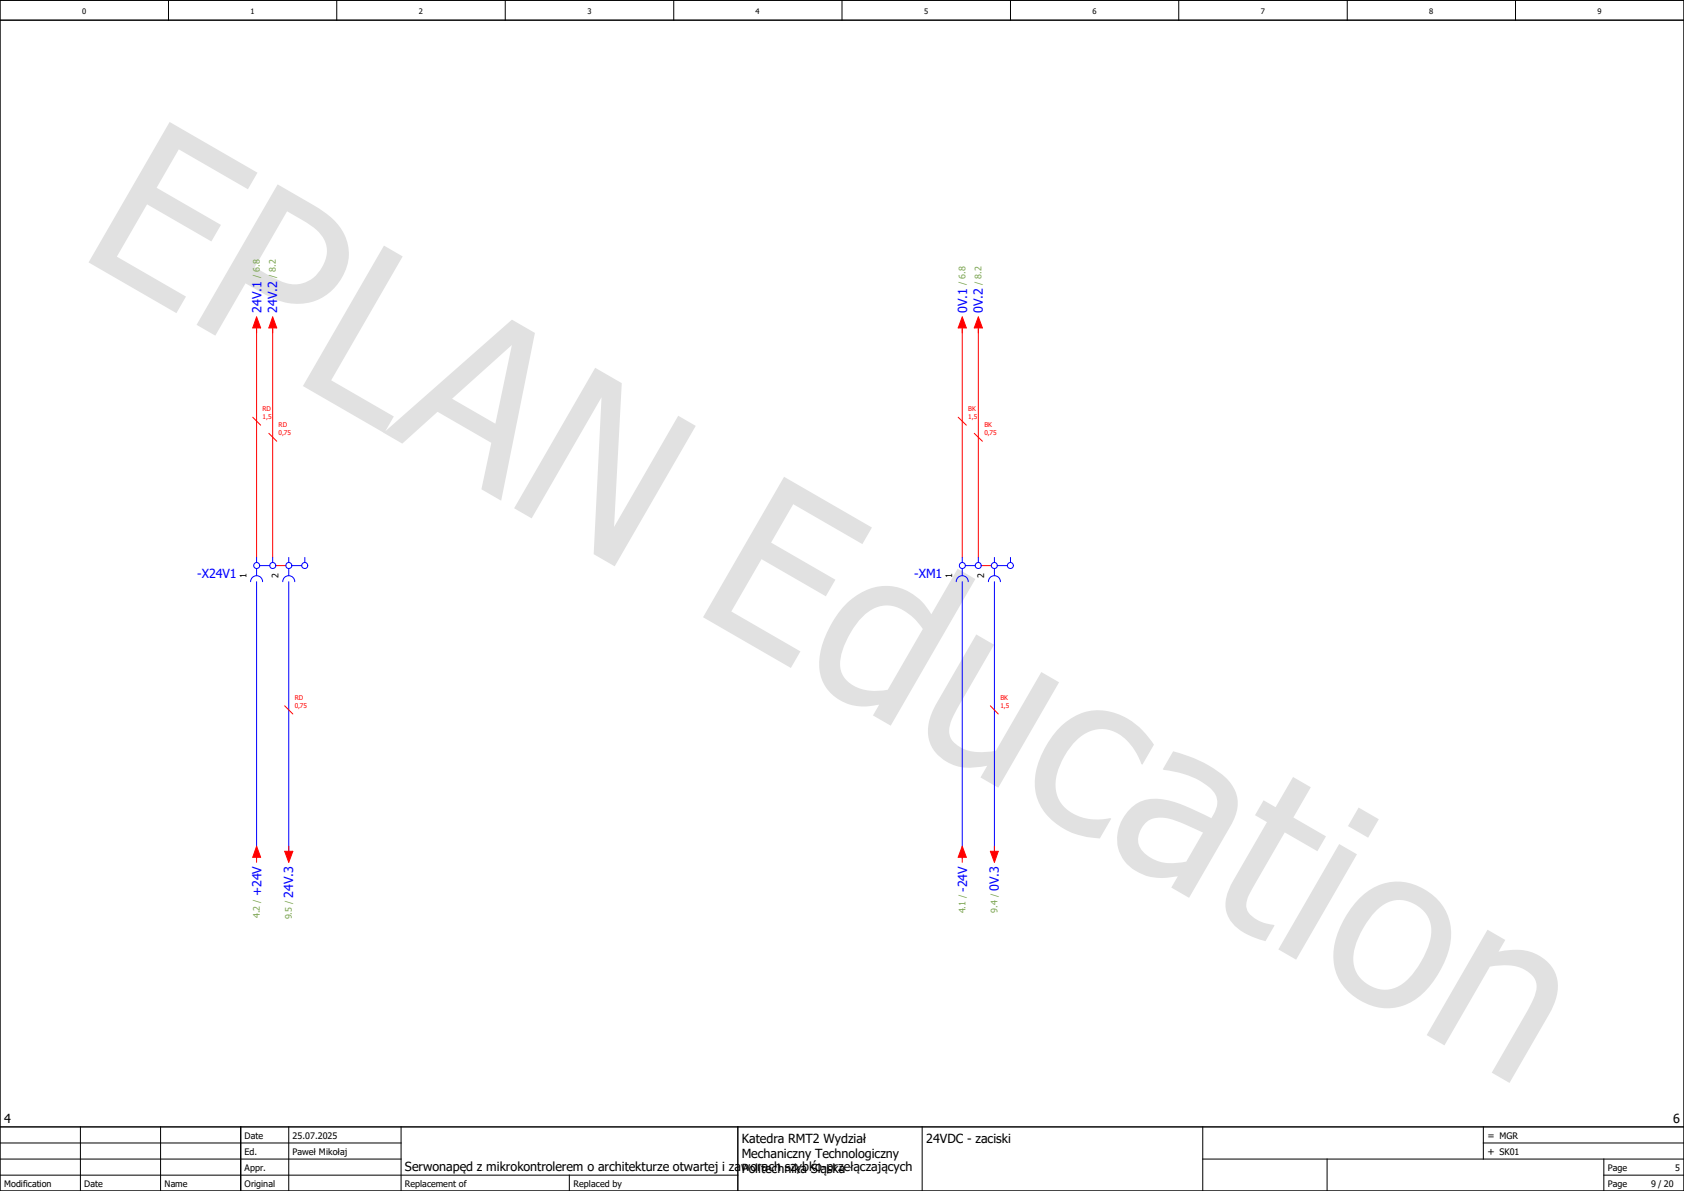
[picture p133: page 9]
RD +²⁴V / 4.2

25.07.2025 Katedra RMT2 Wydział | Politechnika Śląska | 24VDC - zaciski

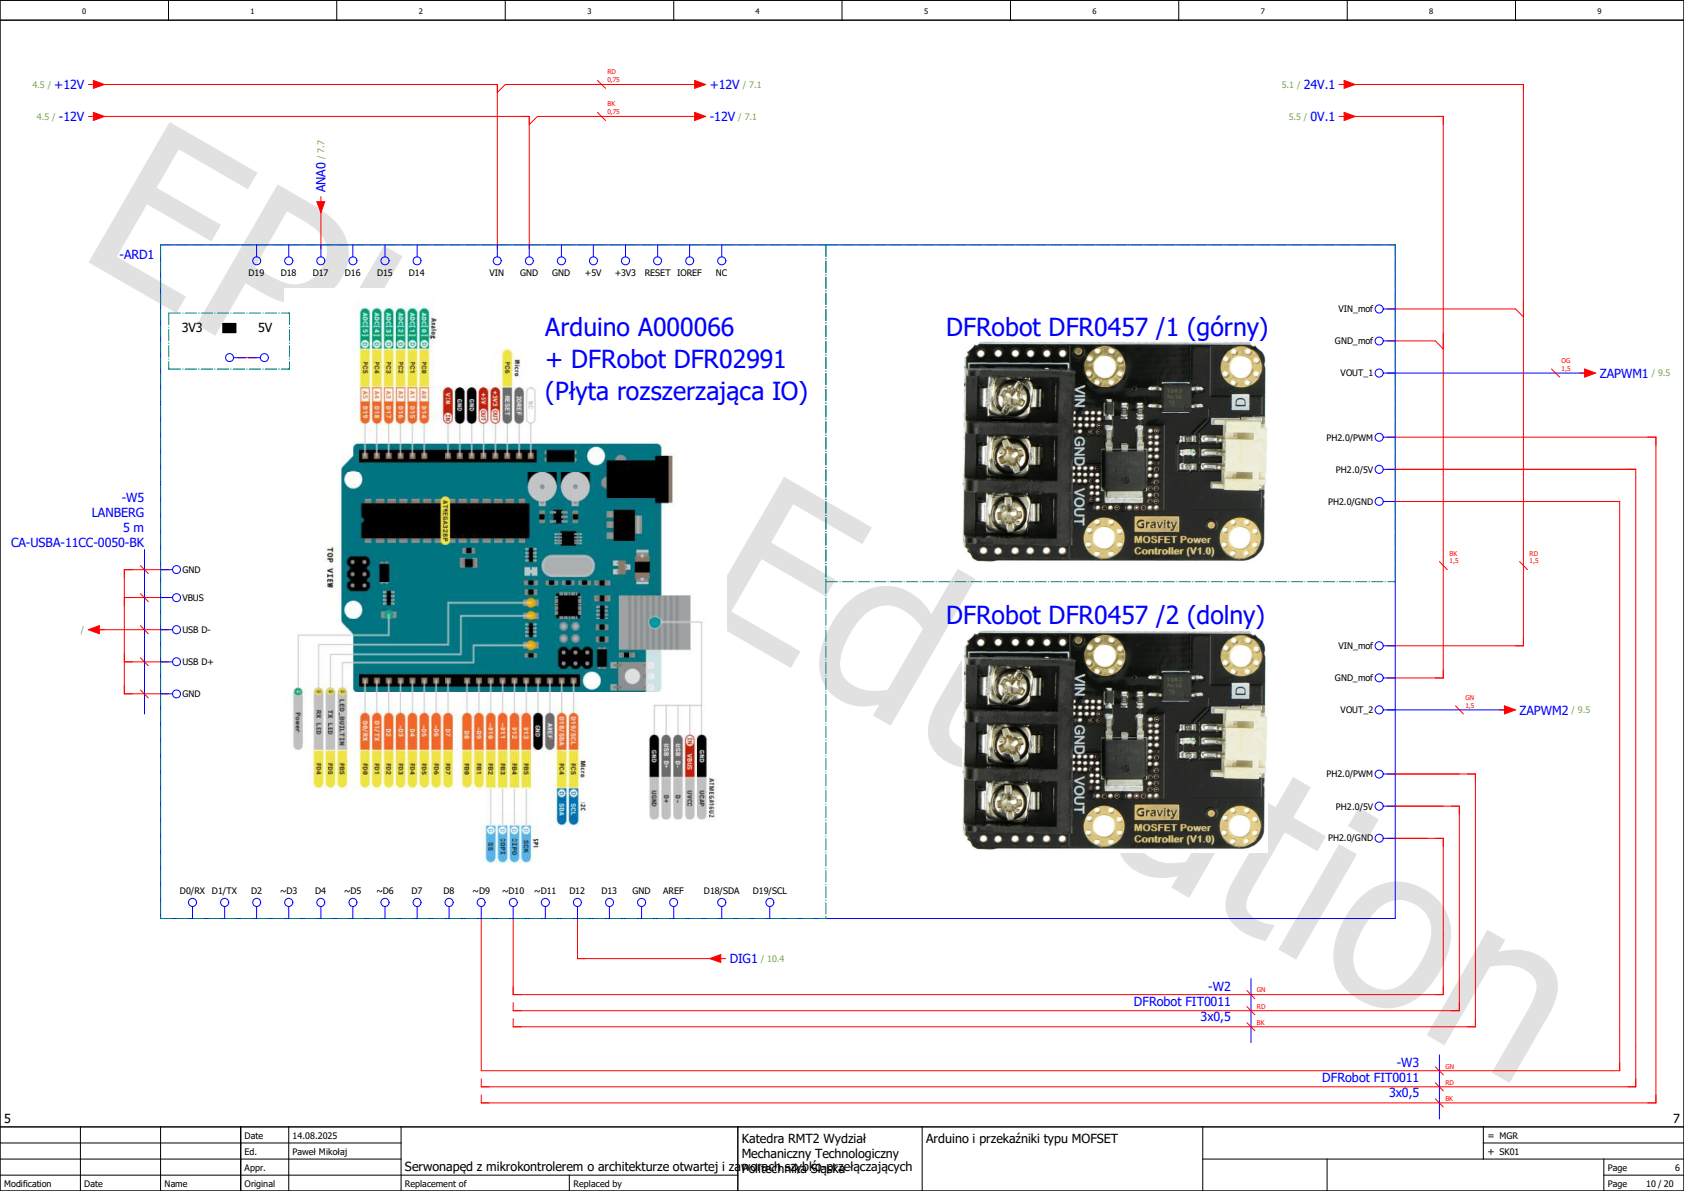
[picture p134: page 10]

Arduino i przekaźniki typu MOFSET

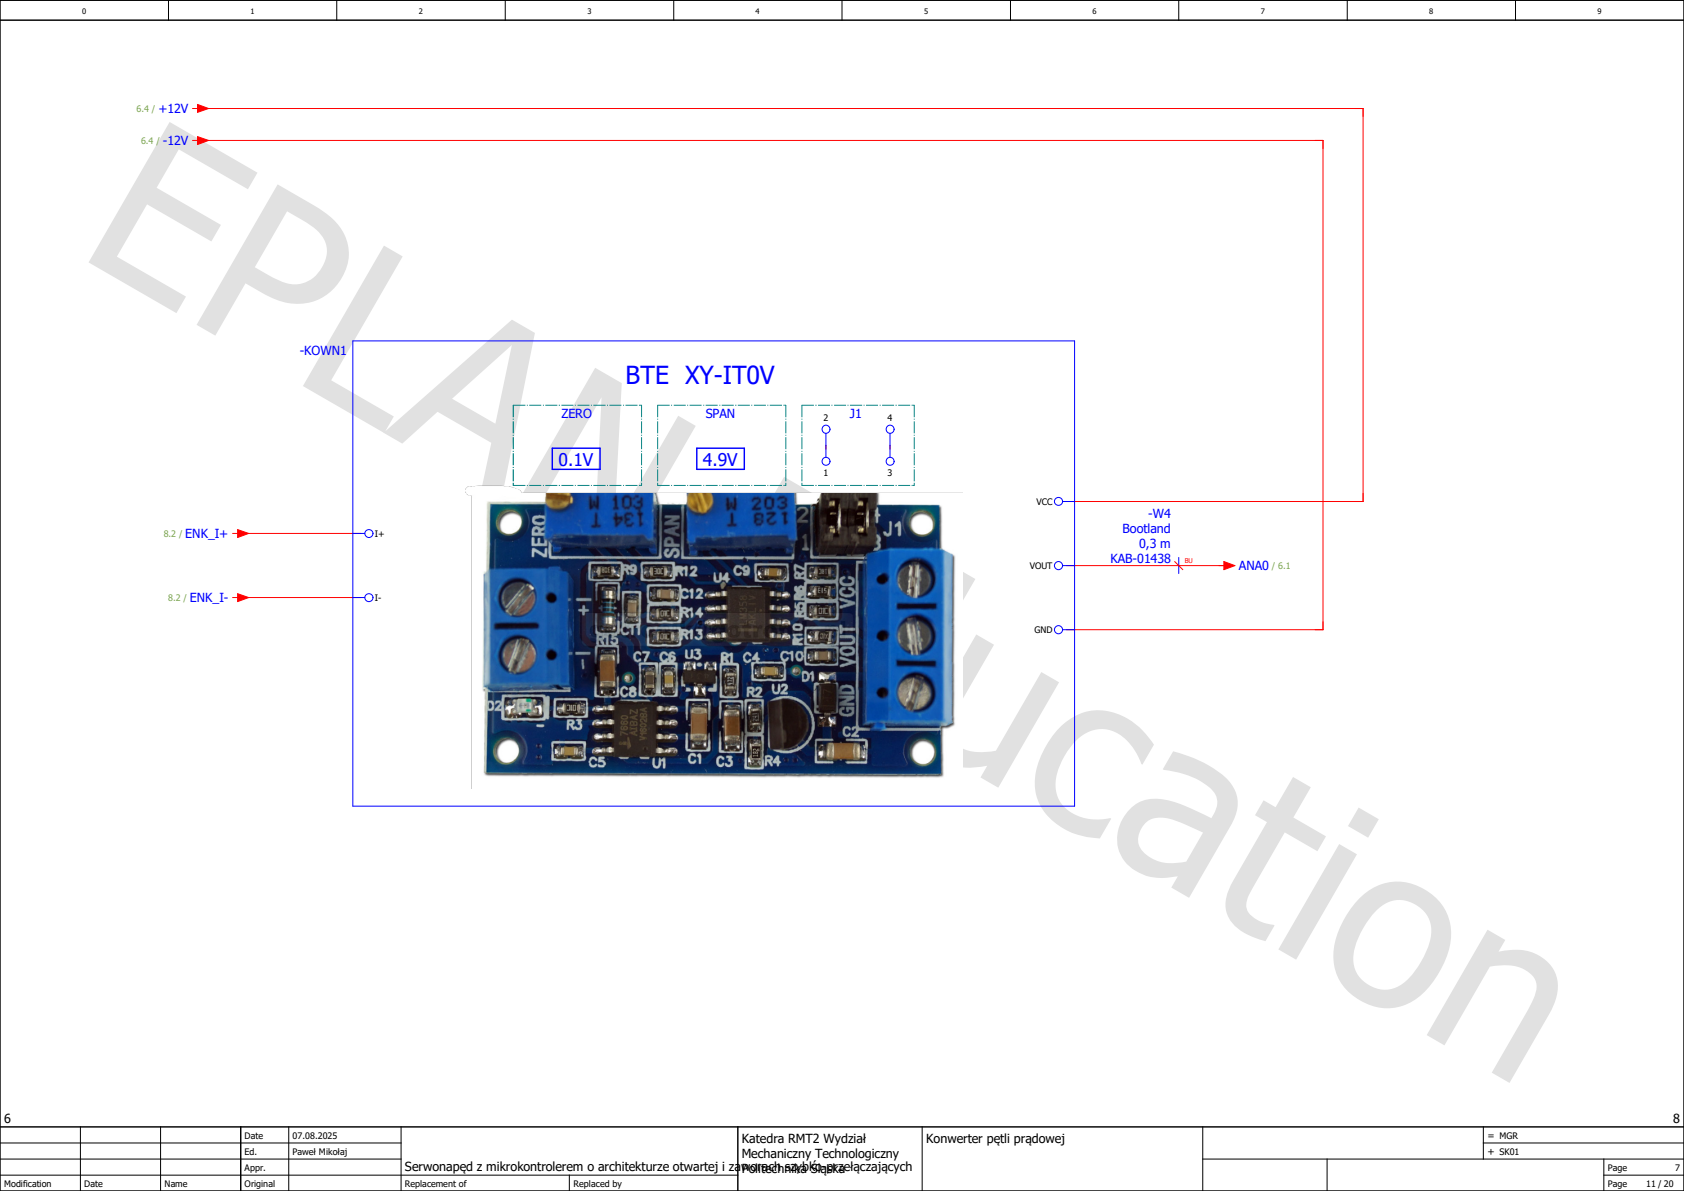
[picture p135: page 11]
BTE XY-IT0V; ZERO; SPAN; -KOWN1; VCC; VOUT; GND; KAB-01438; Bootland; ANA0 / 6.1; 8.2 / ENK_I+; 8.2 / ENK_I-

07.08.2025 Katedra RMT2 Wydział | Politechnika Śląska | Konwerter pętli prądowej

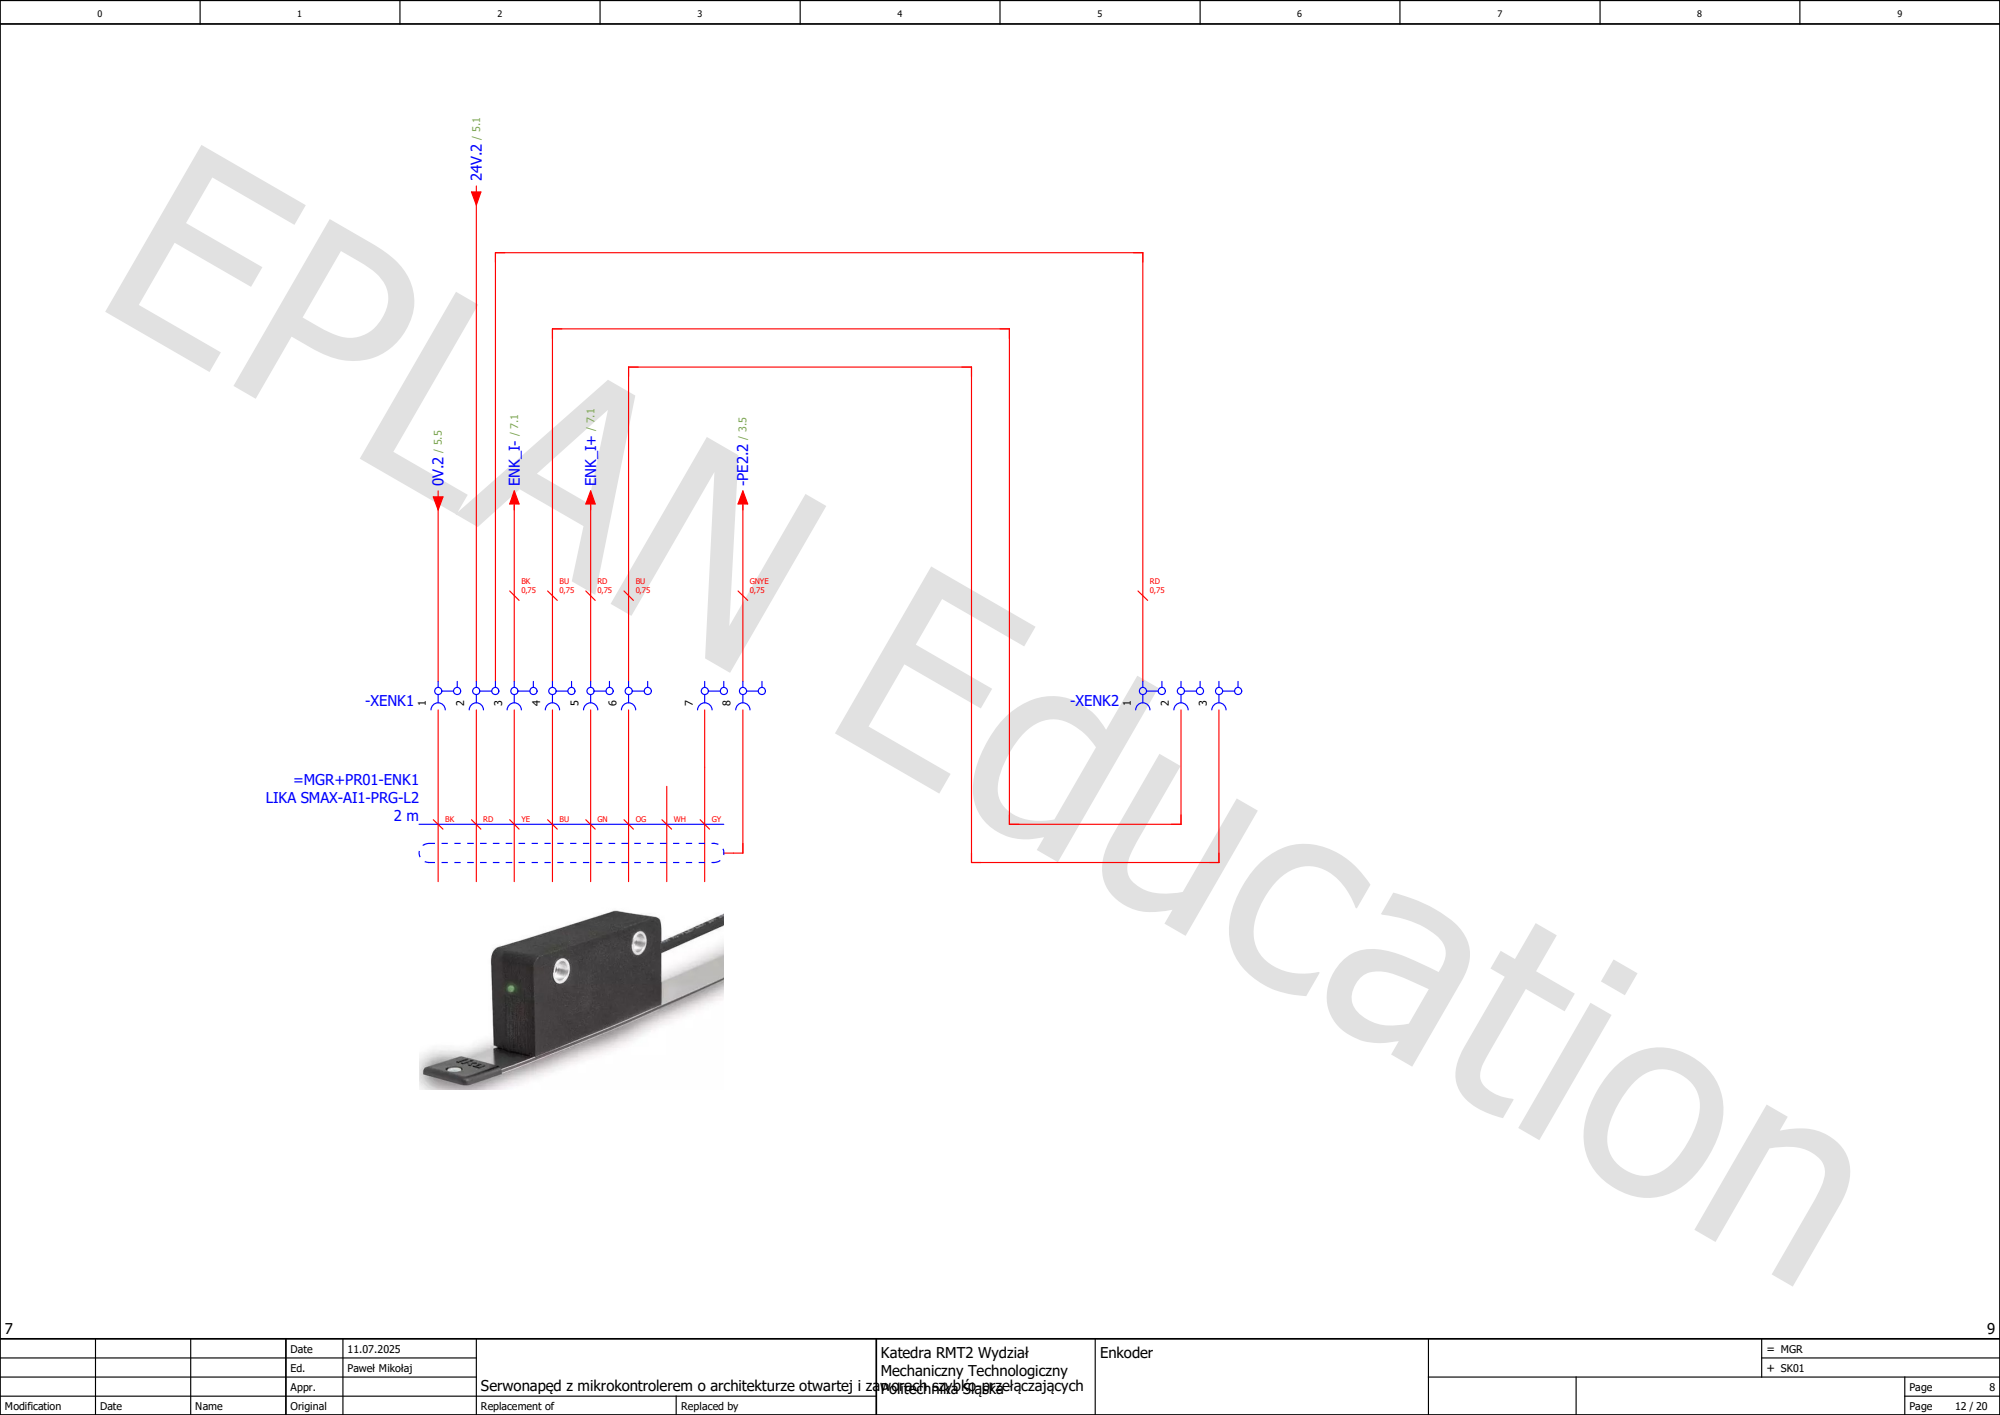
[picture p136: page 12]
-XENK1 1; -XENK2 1; GNYE; BK ²⁴V.2 / 5.1 0V.2 / 5.5; -PE2.2 / 3.5 ENK_I- / 7.1; ENK_I+ / 7.1

=MGR+PR01-ENK1
LIKA SMAX-AI1-PRG-L2

11.07.2025 Katedra RMT2 Wydział | Politechnika Śląska | Enkoder

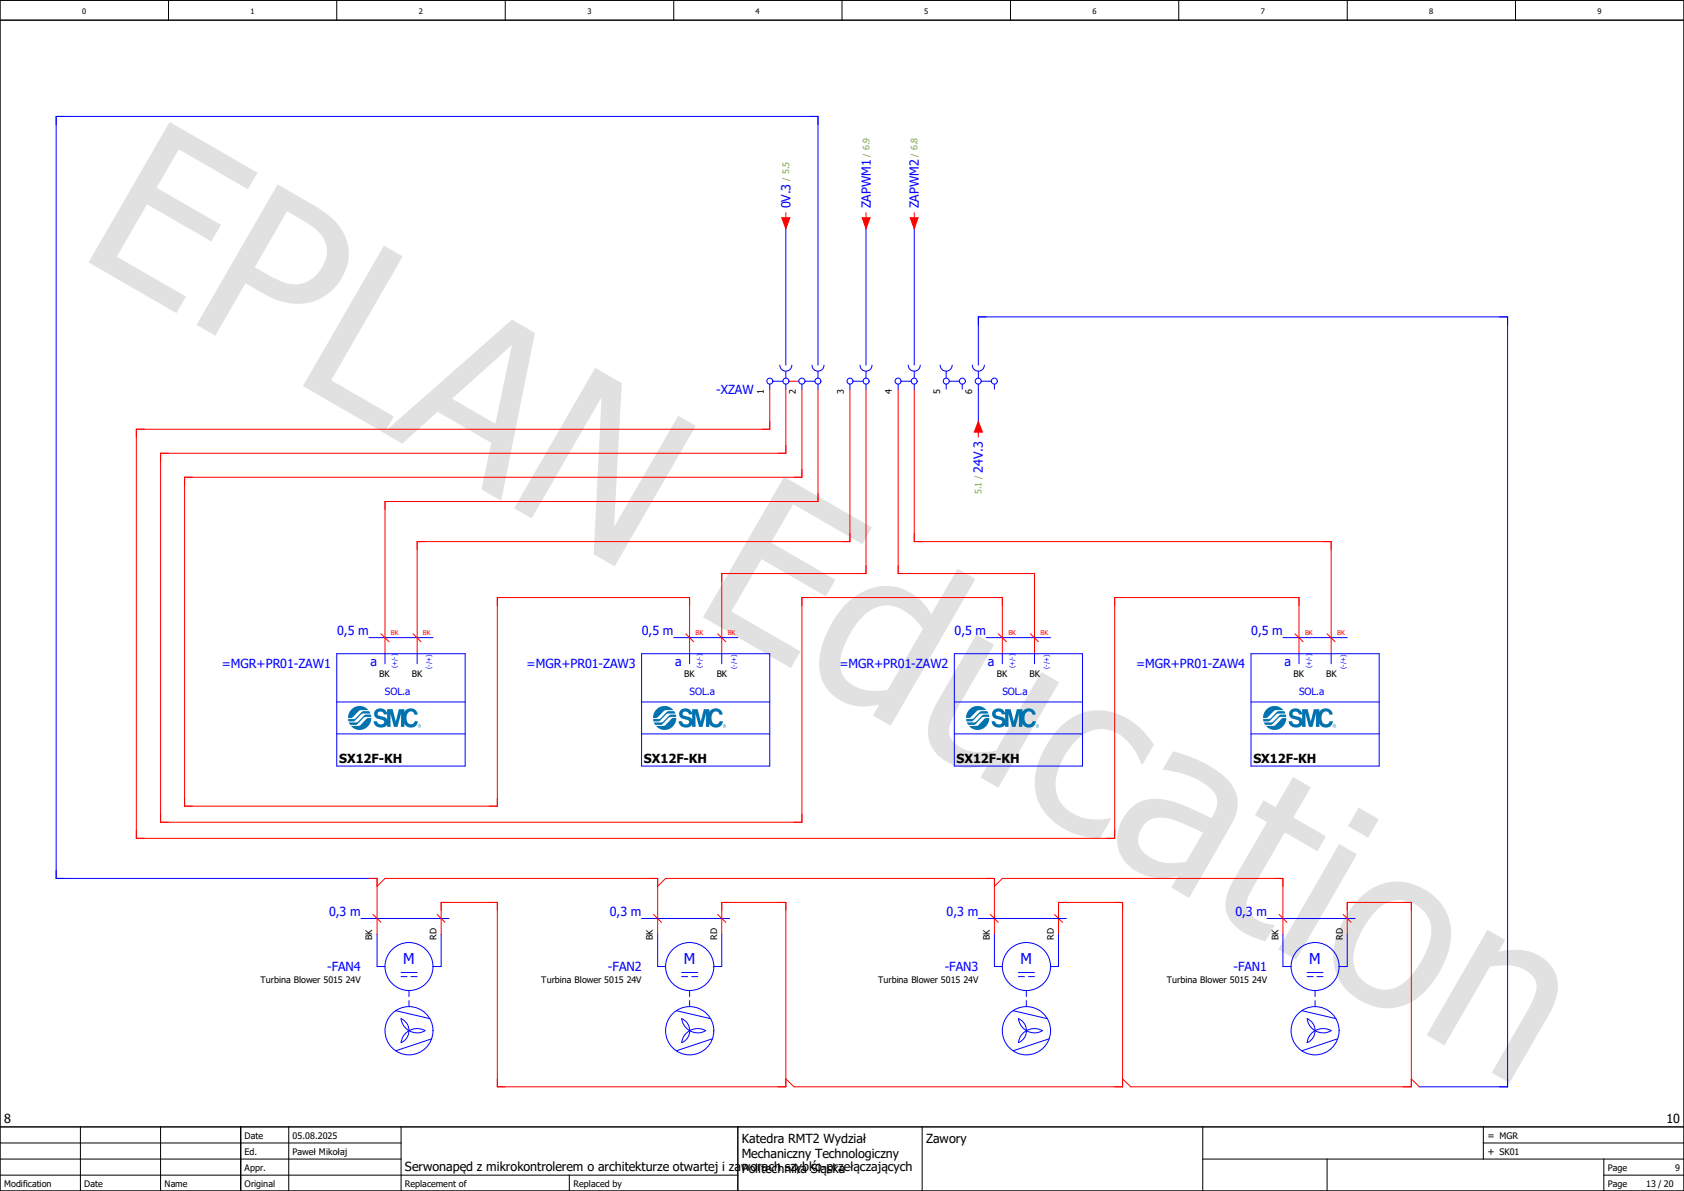
[picture p137: page 13]
SOL.a; =MGR+PR01-ZAW1; =MGR+PR01-ZAW2; =MGR+PR01-ZAW4; =MGR+PR01-ZAW3; -XZAW 1; -FAN1; Turbina Blower 5015 24V BK; -FAN2; Turbina Blower 5015 24V; -FAN3; -FAN4; ZAPWM¹ / 6.9; ZAPWM² / 6.8 0V.3 / 5.5

05.08.2025 Katedra RMT2 Wydział | Politechnika Śląska | Zawory

BK | RD | GN DIG¹ / 6.4

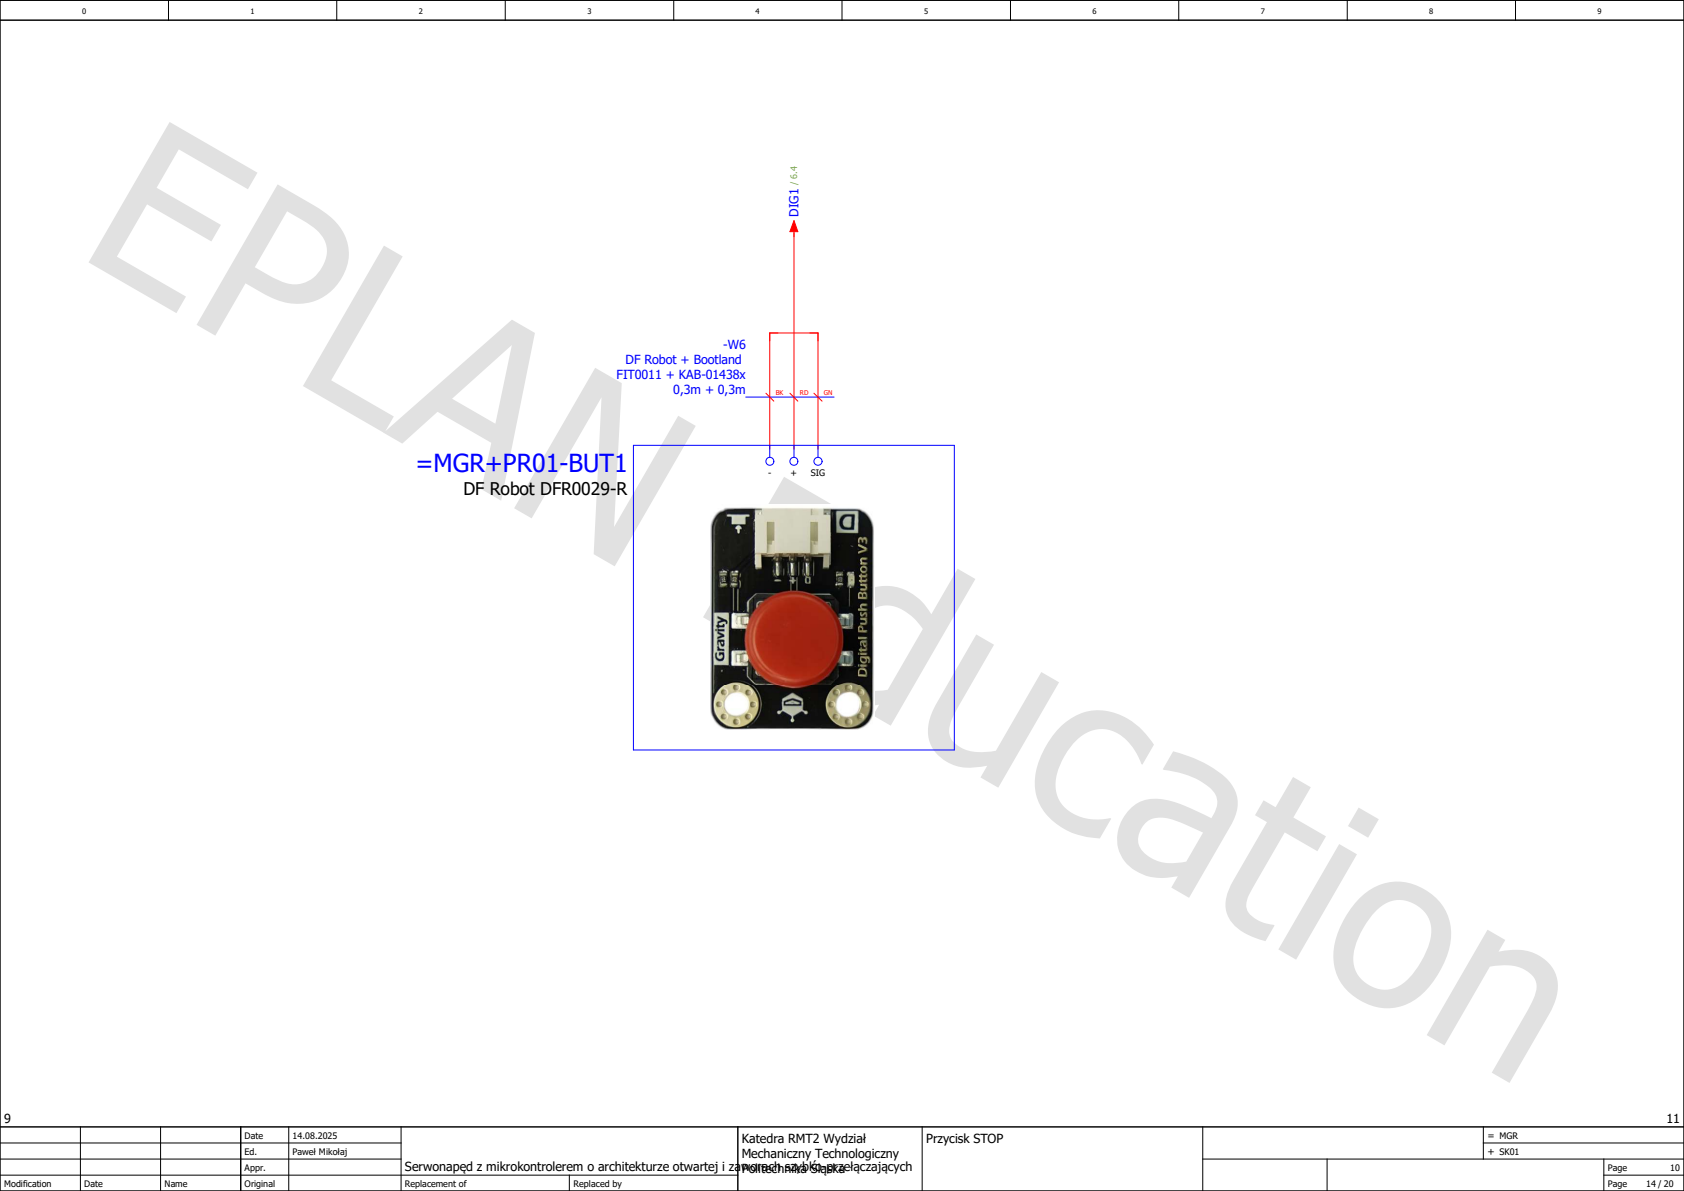
[picture p138: page 14]
Przycisk STOP; Politechnika Śląska; =MGR+PR01-BUT1 DF Robot DFR0029-R; SIG

DF Robot + Bootland
FIT0011 + KAB-01438x

Terminal diagram | F13_003

## Strip

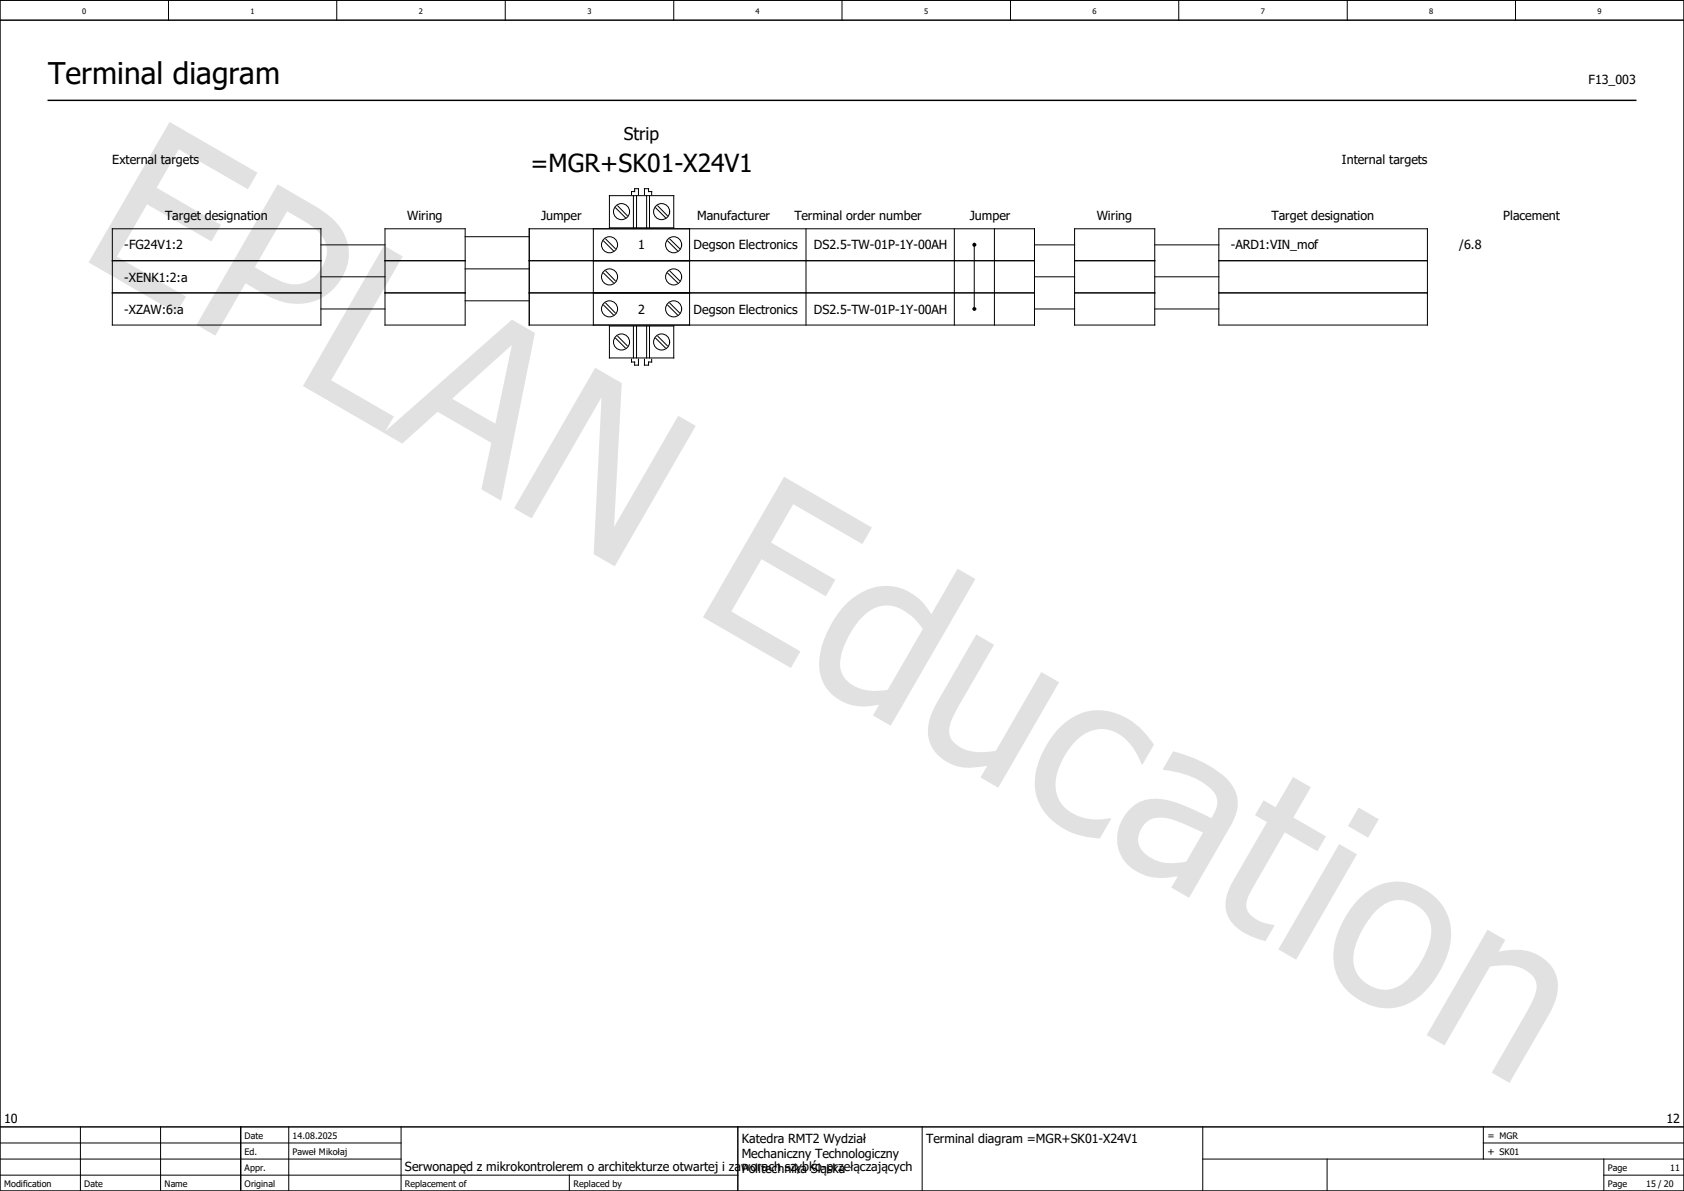
[picture p139: page 15]
Politechnika Śląska; Target designation; Target designation Wiring; Wiring Jumper; Jumper Terminal order number; External targets; Internal targets; Manufacturer; Placement; =MGR+SK01-X24V1; Degson Electronics; -ARD1:VIN_mof; -XENK1:2:a; -XZAW:6:a

Terminal diagram =MGR+SK01-X24V1

Terminal diagram | F13_003

## Strip

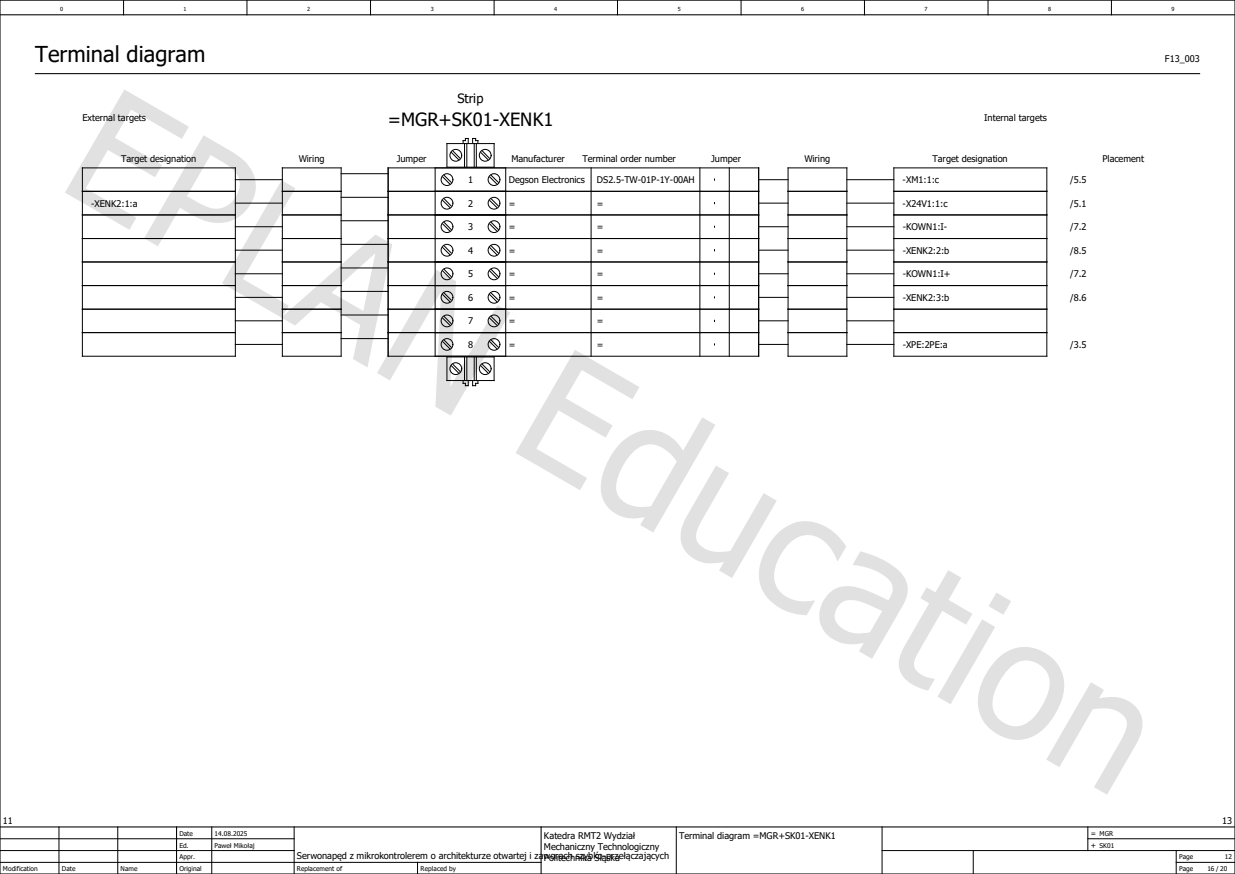
[picture p140: page 16]
Politechnika Śląska; Target designation; Target designation Wiring; Wiring Jumper; Jumper Terminal order number; External targets; Internal targets; Manufacturer; Placement; =MGR+SK01-XENK1; Degson Electronics; -XENK2:1:a; -KOWN1:I-; -XENK2:2:b; -KOWN1:I+; -XENK2:3:b; -XPE:2PE:a

Terminal diagram =MGR+SK01-XENK1

Terminal diagram | F13_003

## Strip

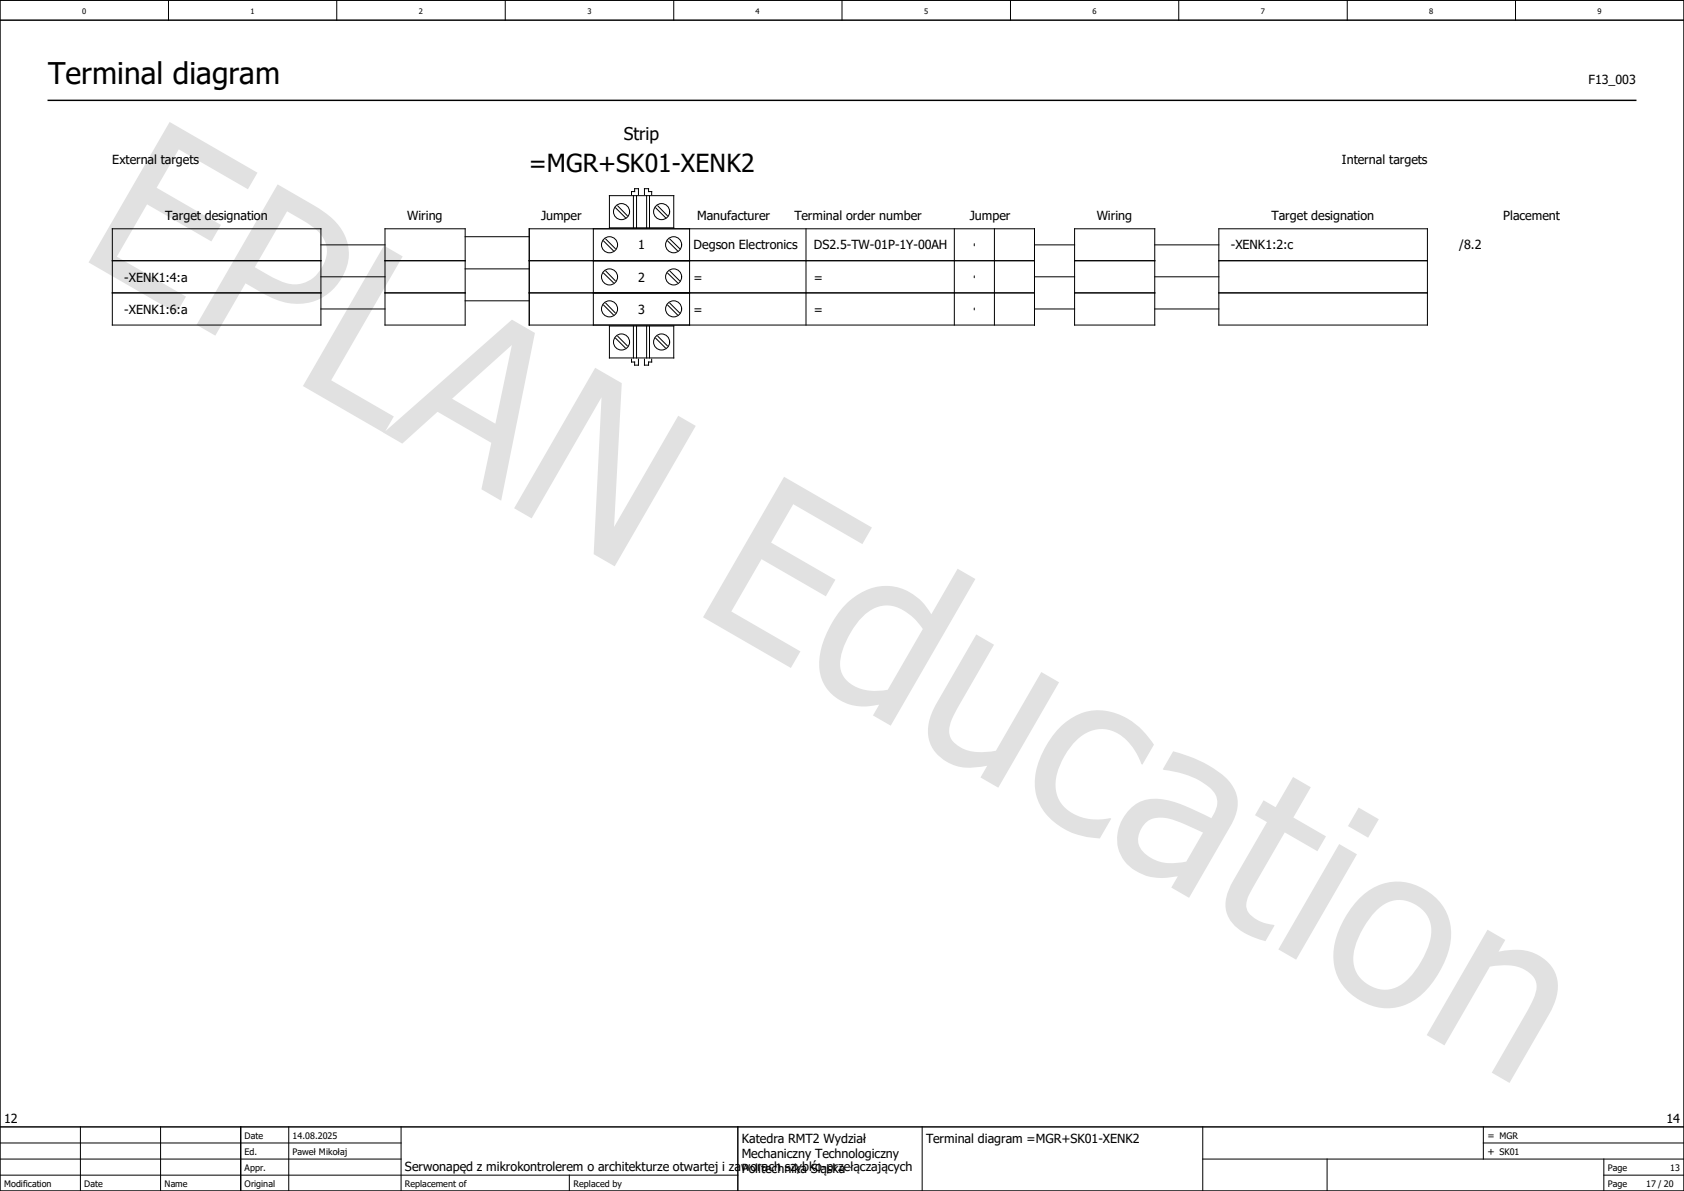
[picture p141: page 17]
Politechnika Śląska; Target designation; Target designation Wiring; Wiring Jumper; Jumper Terminal order number; External targets; Internal targets; Manufacturer; Placement; =MGR+SK01-XENK2; Degson Electronics; -XENK1:2:c; -XENK1:4:a; -XENK1:6:a

Terminal diagram =MGR+SK01-XENK2

Terminal diagram | F13_003

## Strip

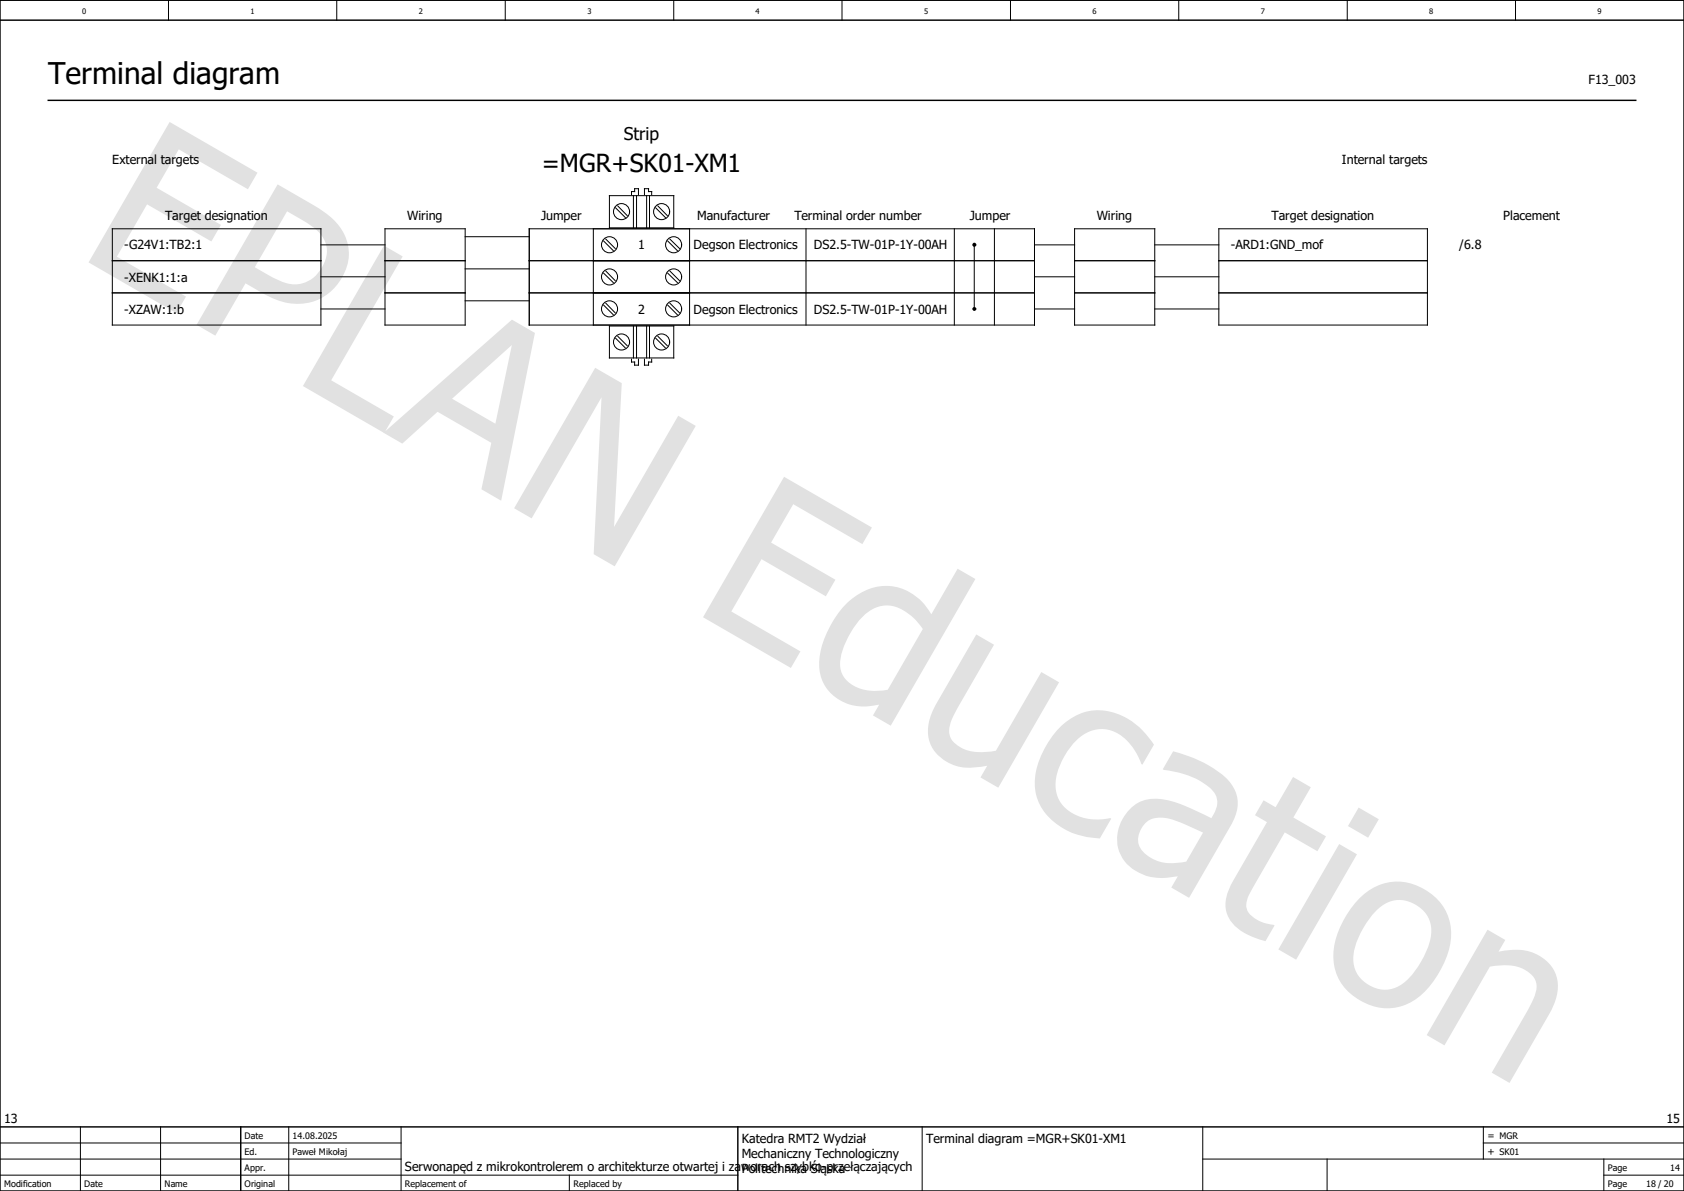
[picture p142: page 18]
Politechnika Śląska; Target designation; Target designation Wiring; Wiring Jumper; Jumper Terminal order number; External targets; Internal targets; Manufacturer; Placement; =MGR+SK01-XM1; Degson Electronics; -ARD1:GND_mof; -XENK1:1:a; -XZAW:1:b

Terminal diagram =MGR+SK01-XM1

Terminal diagram | F13_003

## Strip

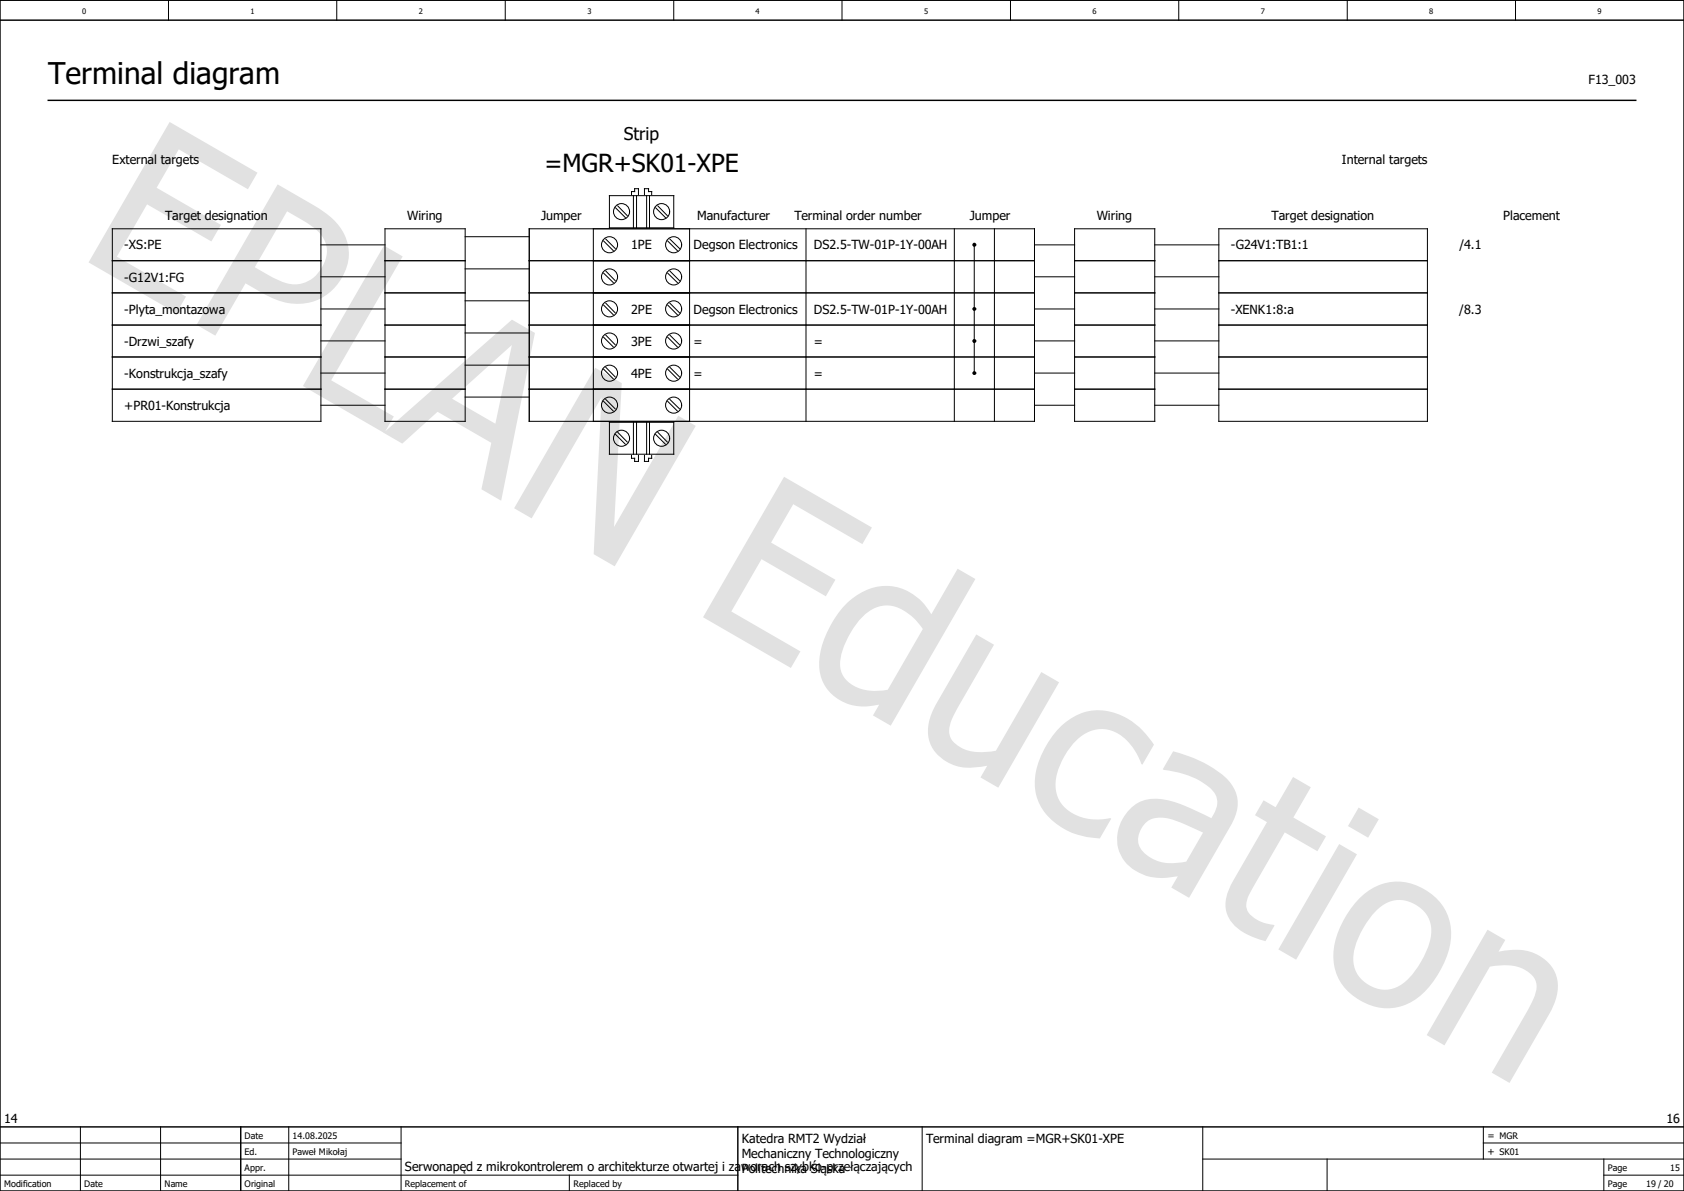
[picture p143: page 19]
Politechnika Śląska; Target designation; Target designation Wiring; Wiring Jumper; Jumper Terminal order number; External targets; Internal targets; Manufacturer; Placement; =MGR+SK01-XPE; Degson Electronics; -Plyta_montazowa; -XENK1:8:a; -Drzwi_szafy; -Konstrukcja_szafy; +PR01-Konstrukcja

Terminal diagram =MGR+SK01-XPE

Terminal diagram | F13_003

## Strip

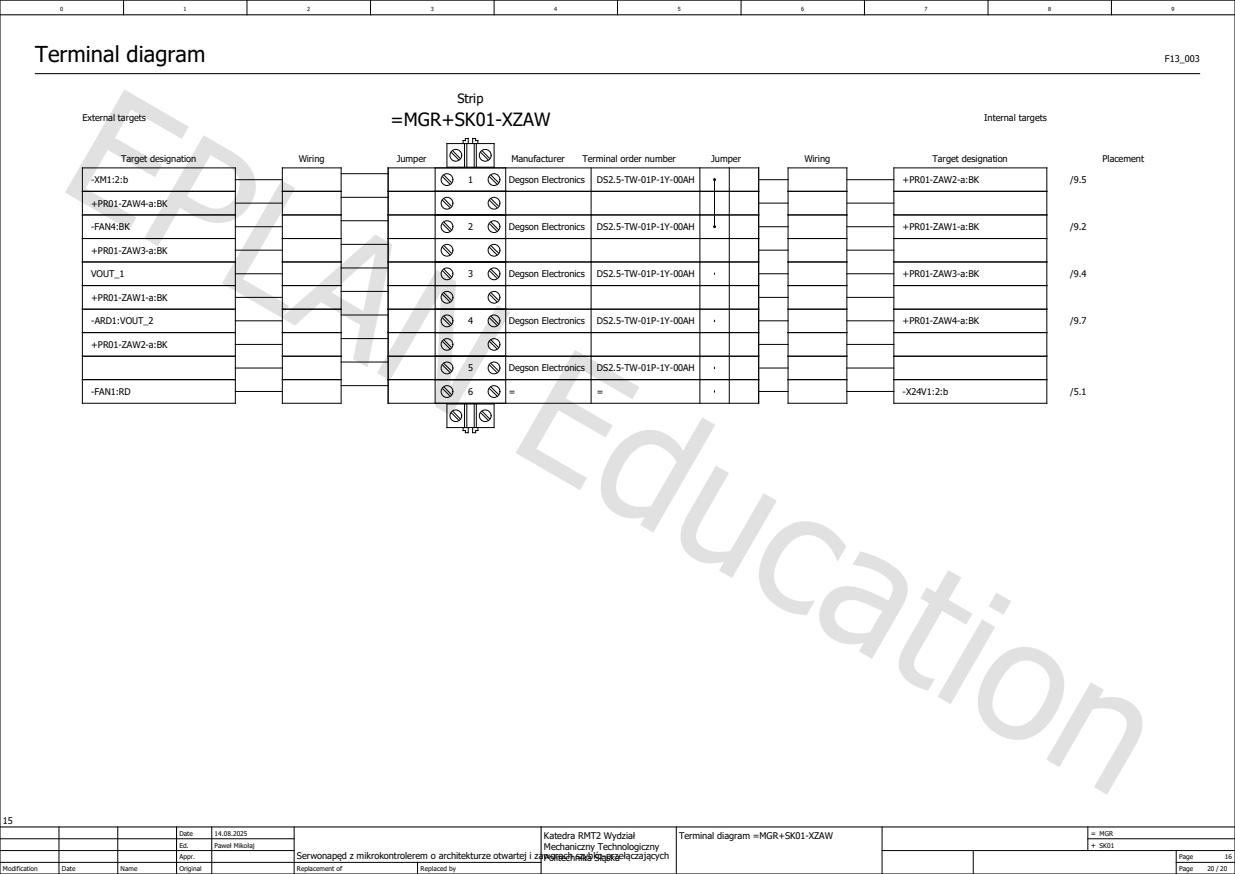
[picture p144: page 20]
Politechnika Śląska; Target designation; Target designation Wiring; Wiring Jumper; Jumper Terminal order number; External targets; Internal targets; Manufacturer; Placement; =MGR+SK01-XZAW; Degson Electronics; +PR01-ZAW2-a:BK; +PR01-ZAW4-a:BK; -FAN4:BK; +PR01-ZAW1-a:BK; +PR01-ZAW3-a:BK; VOUT_1; -ARD1:VOUT_2; -FAN1:RD

Terminal diagram =MGR+SK01-XZAW

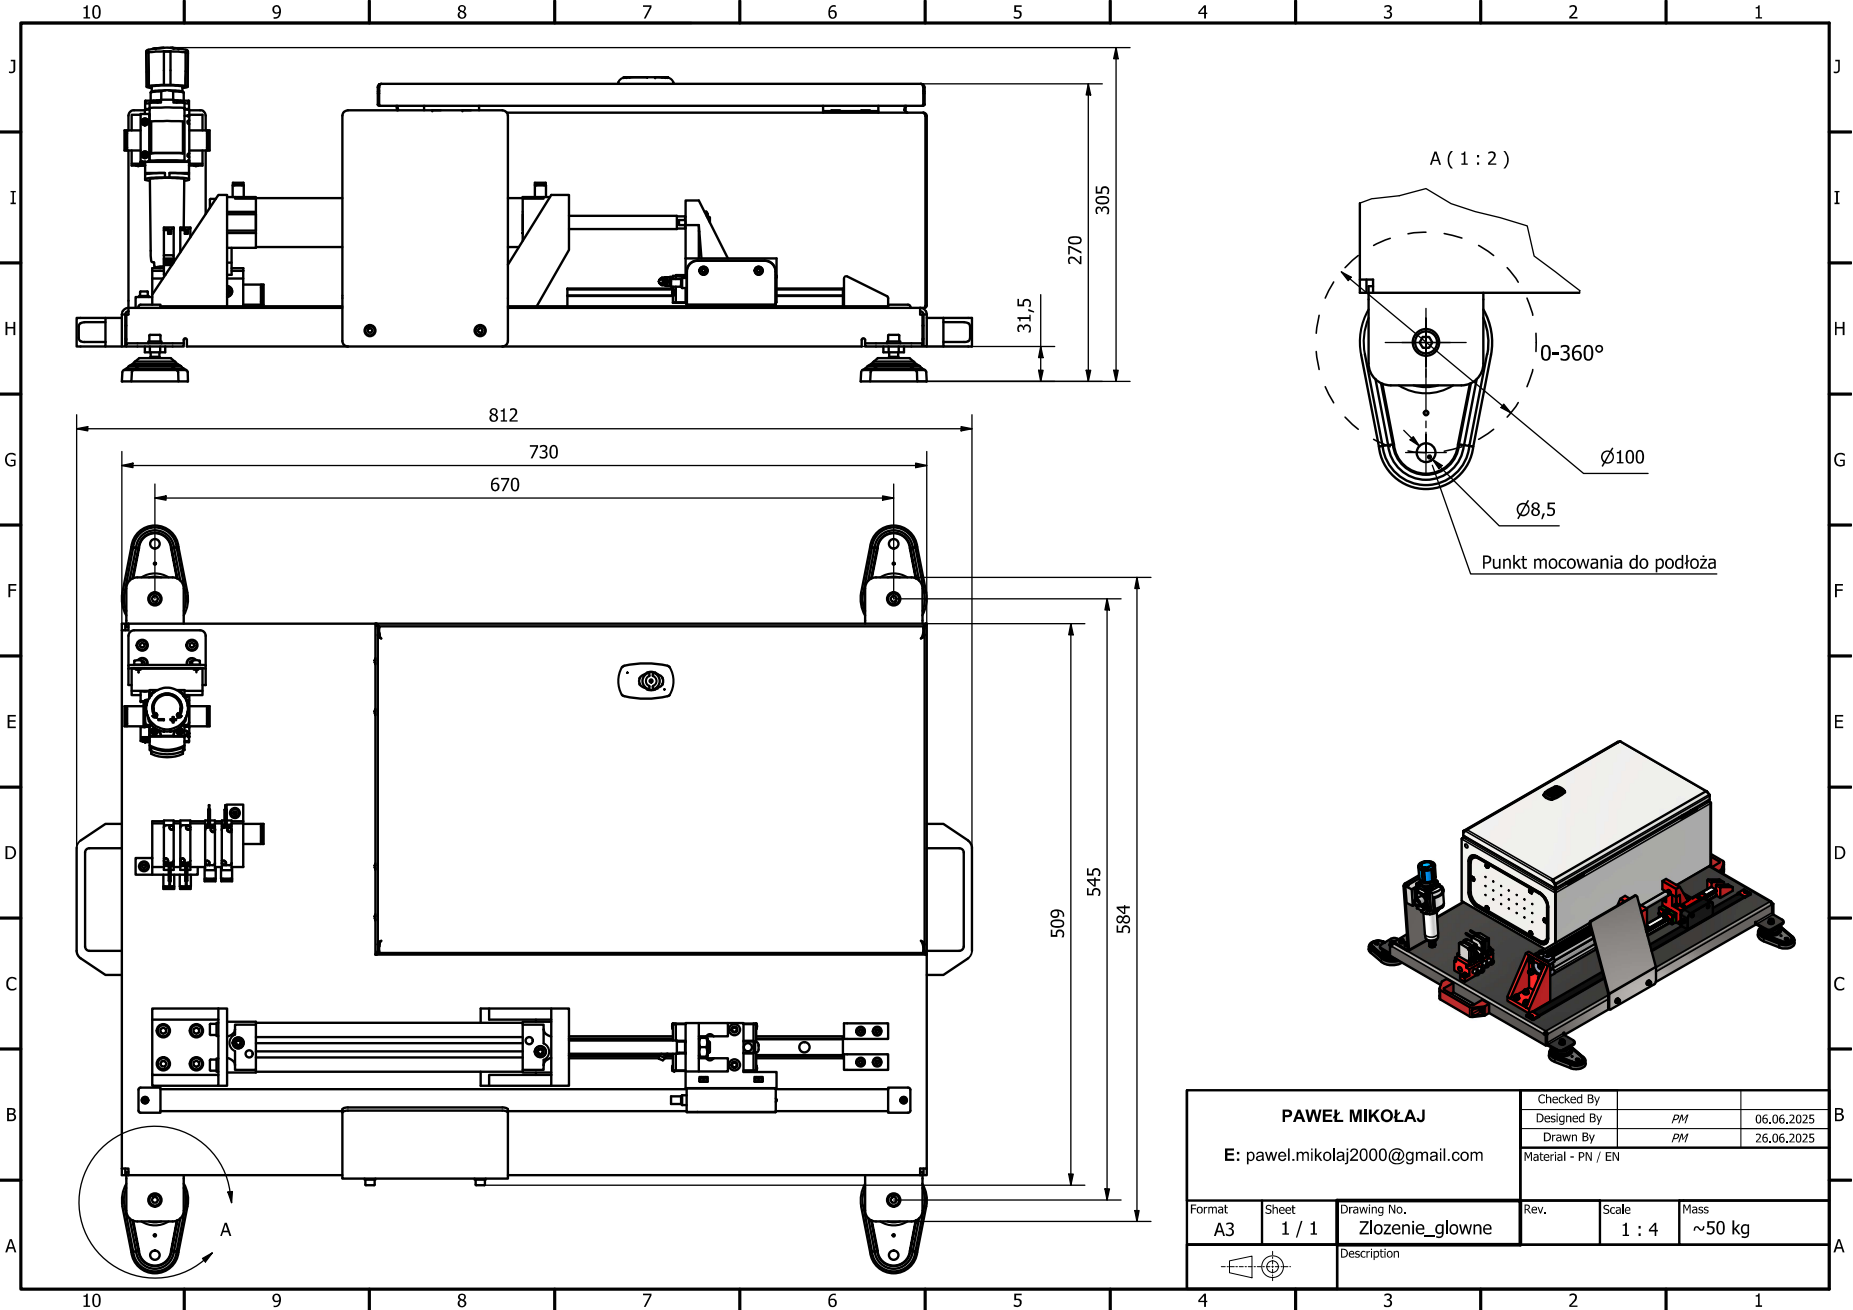
[picture p145: page 21]
